hypocrasy/NPUSoC/doc/海报.png

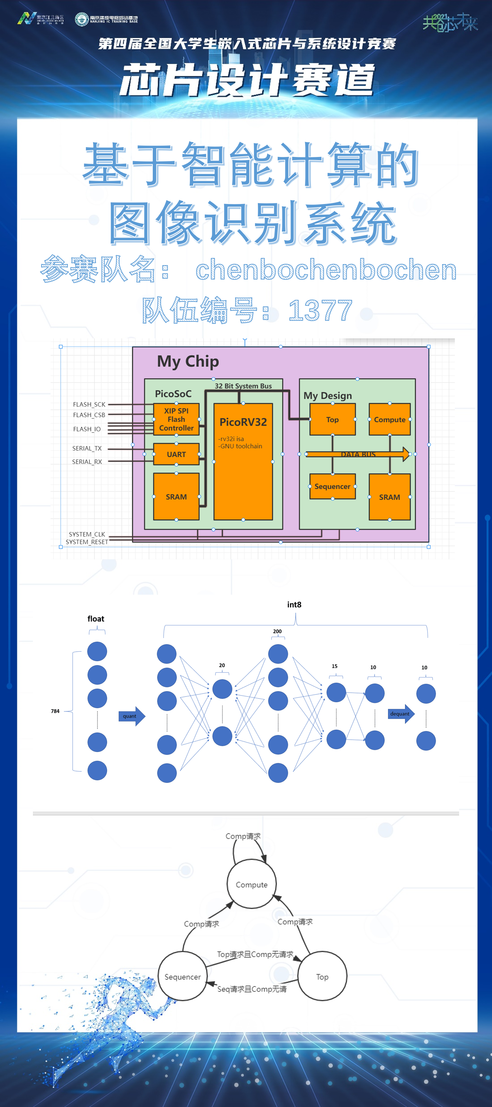
doc/海报.png
