hypocrasy/NPUSoC/spyglass/spyglass-1/consolidated_reports/Design_Read/README

################################################################################
#
# This file has been generated by SpyGlass:
#     Consolidated Reports Created by: team3_03
#     Consolidated Reports Created on: Thu Oct  7 14:20:48 2021
#     Working Directory              : /home/users/team3_03/Desktop/design2021/spyglass
#     Consolidated Reports Location  : ./spyglass-1/consolidated_reports/Design_Read/
#     SpyGlass Version               : SpyGlass_vQ-2020.03-SP2-6
#
################################################################################

This directory contains critical reports generated in current run
In case this directory needs to be compressed using gtar, you may use - 

    % gtar -cvzf <compressed_tar_file_name> ./spyglass-1/consolidated_reports/Design_Read/
