hypocrasy/NPUSoC/doc/芯片设计验证报告.pdf

## 第四届全国大学生嵌入式芯片与系统设计竞赛

## 芯片设计赛道

# 芯片设计验证报告

作品名称（必填）： 基于智能计算的图像识别系统

队伍编号（必填）： | 1377______________

参赛队名（必填）： chenbochenbochen_______

日期：2021 年 10 月 7 日

第四届全国大学生嵌入式芯片与系统设计竞赛芯片设计赛道

1

## 1. 测试点列表

简要说明测试点分解策略

测试点名称 | 覆盖范围 | 覆盖方式
功能类： Call LdAdd Excute MACC MACCZ MAX MMAXN MMAXZ MNIST ReLU Store | 典型值 | coverage
| 边界值 | coverage
| 异常值 | directtest
| Cross | coverage

接口类:
场景类（选填，有可以填）
性能类（选填，有可以填）
异常类（选填，有可以填）

## 2. 验证方案 主要验证组件

组件名 | 功能描述
Sequence | 发射指令并处理跳转指令
Compute | 对数据进行计算处理返回结果
Top | 接受外部的 io 指令

## 验证方案：框图+说明

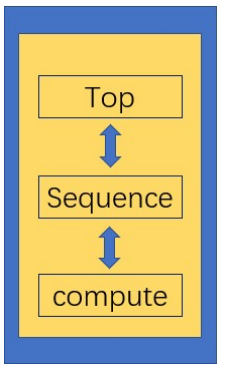
[picture p28: figure]
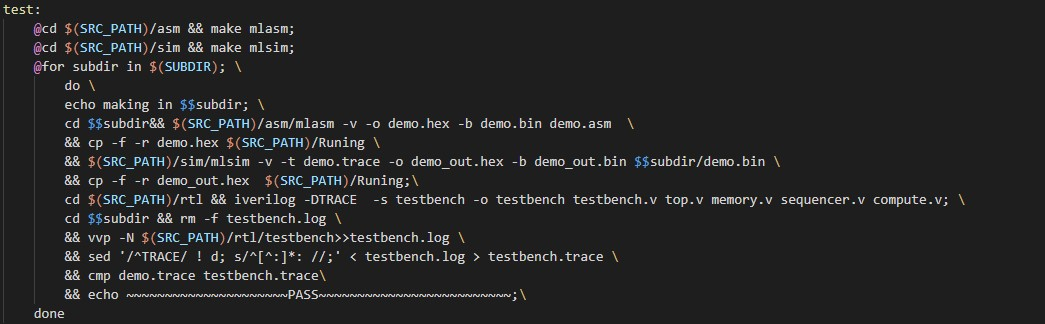
[picture p29: figure]

2

根据框图简要说明验证方案的流程
首 先 将 testcase 通 过 编 译 汇 编 指 令 为 hex 文 件 ， 通 过 对 top_moudule 施加 testbench 后，top 进行状态跳转让 sequence 发射指令至 compute 进行运算，运算成功后将结果写回存储，然 后对比行为模型的存储和过程的 trace 即可。

## 3. 功能覆盖率分析 覆盖率结果（截图）

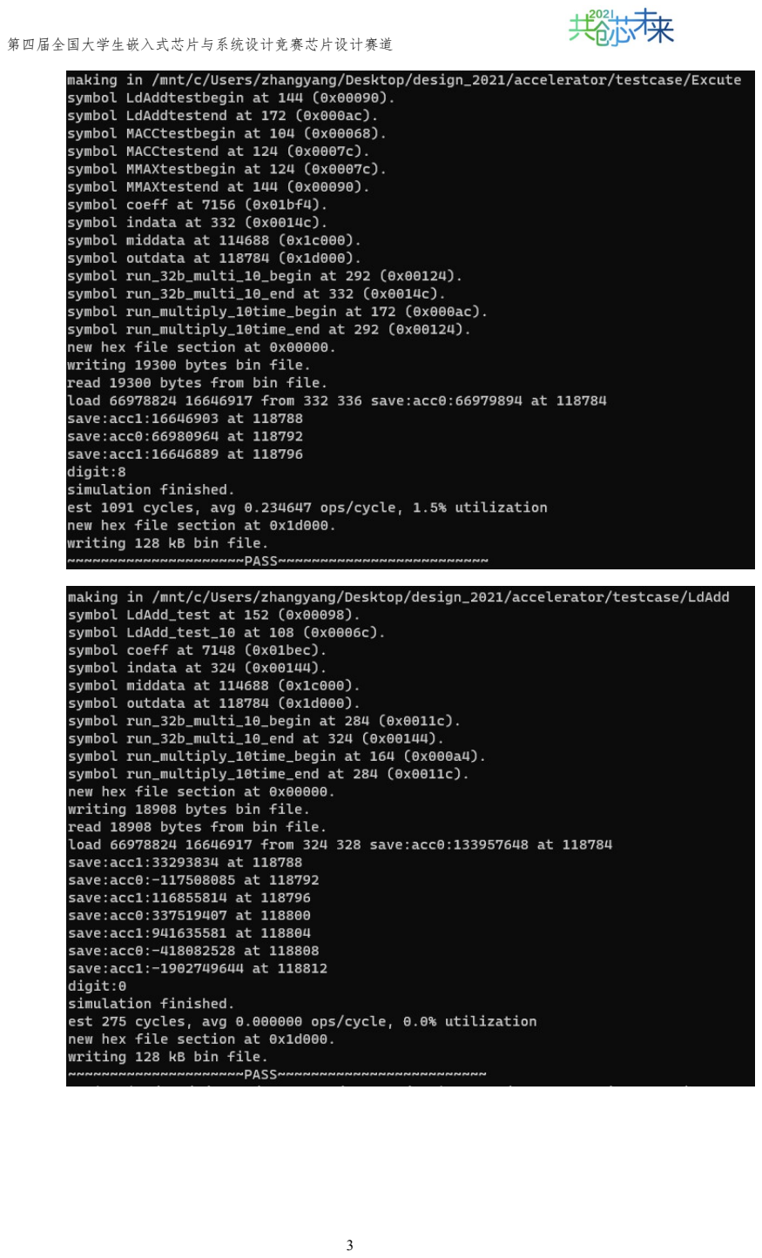
[picture p30: page 4]

3

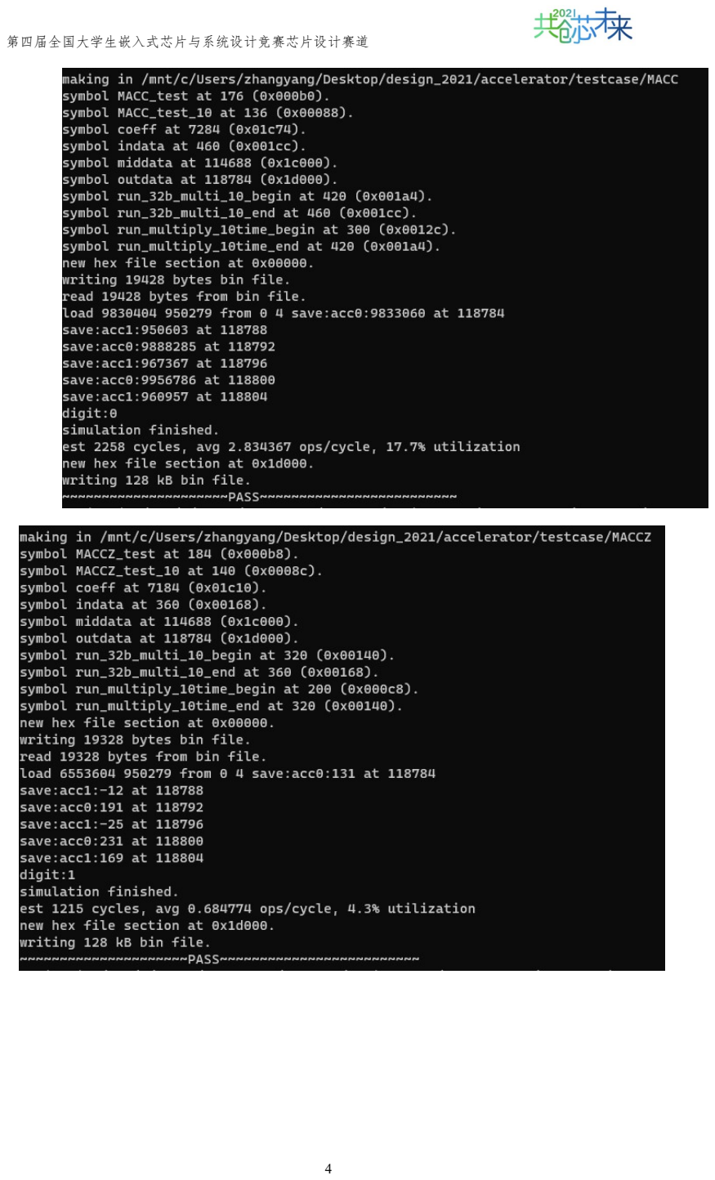
[picture p31: page 5]

4

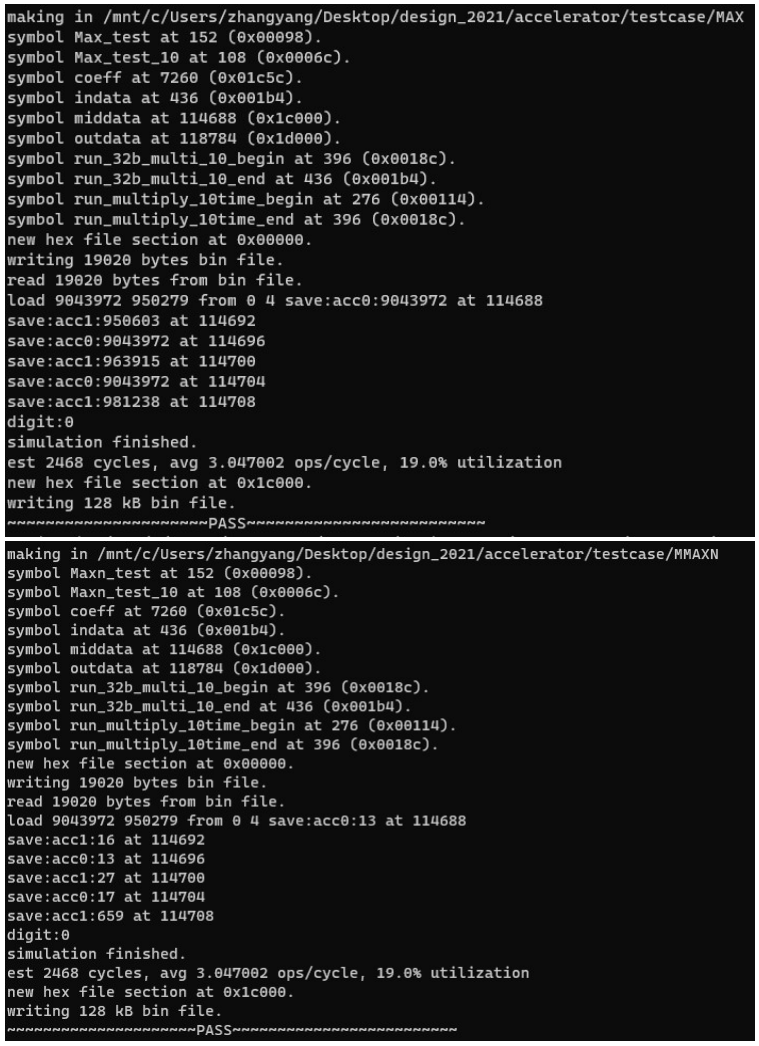
[picture p32: figure]

5

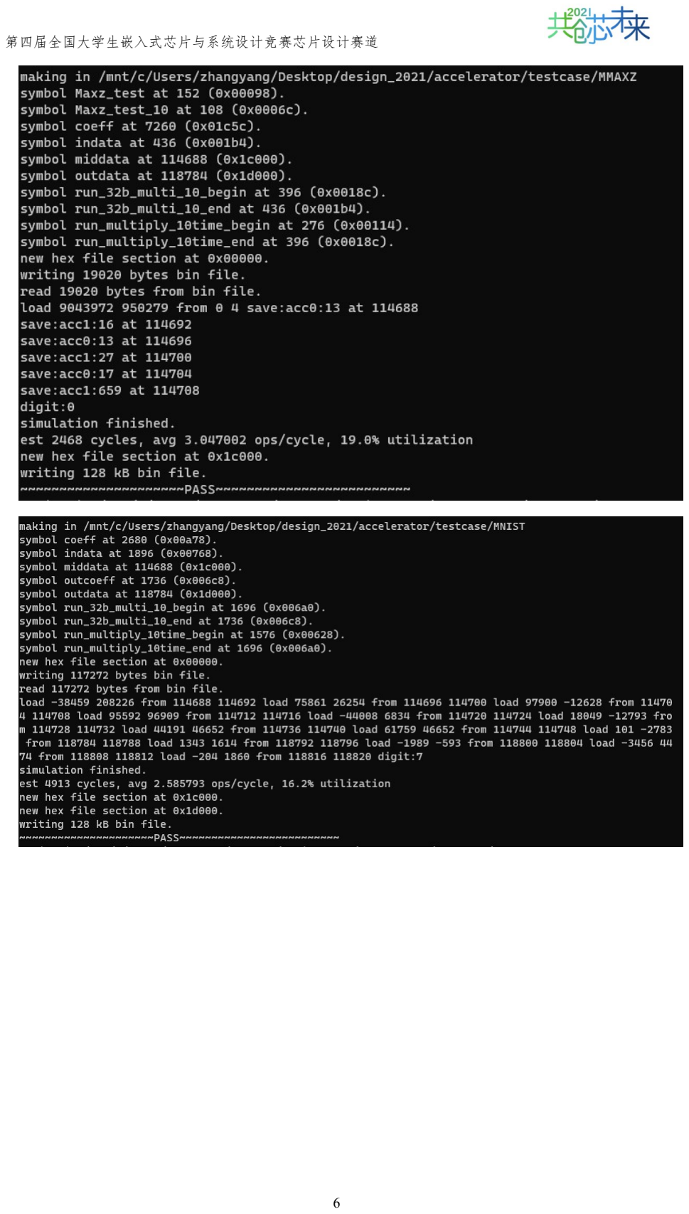
[picture p33: page 7]

6

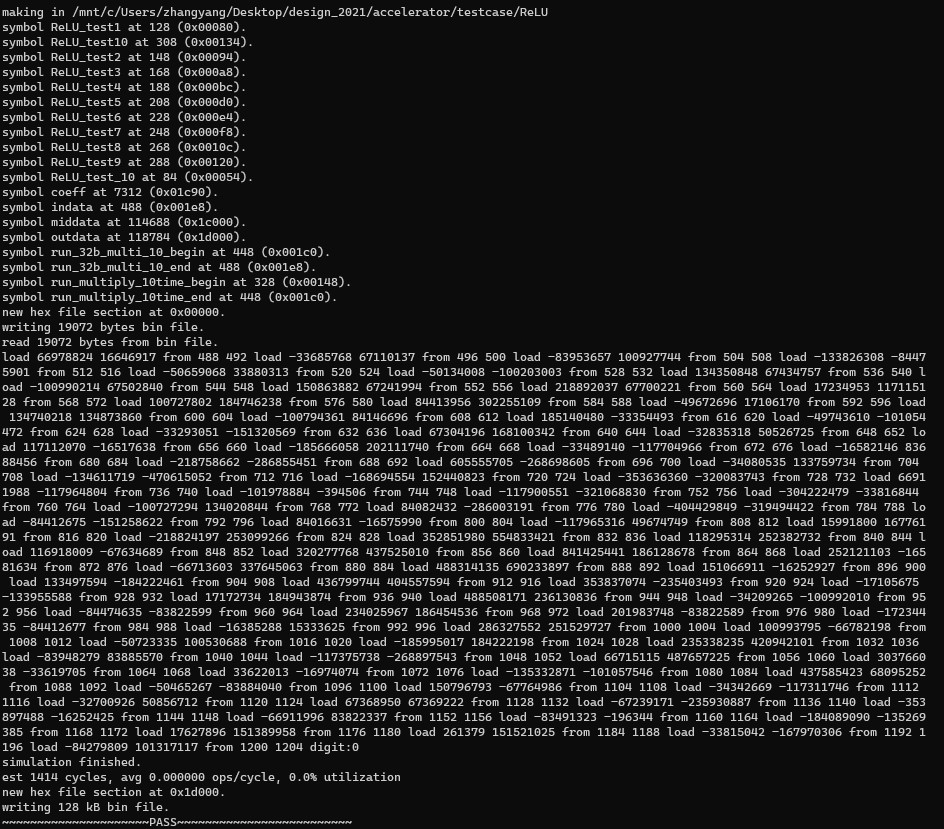
[picture p34: figure]

7

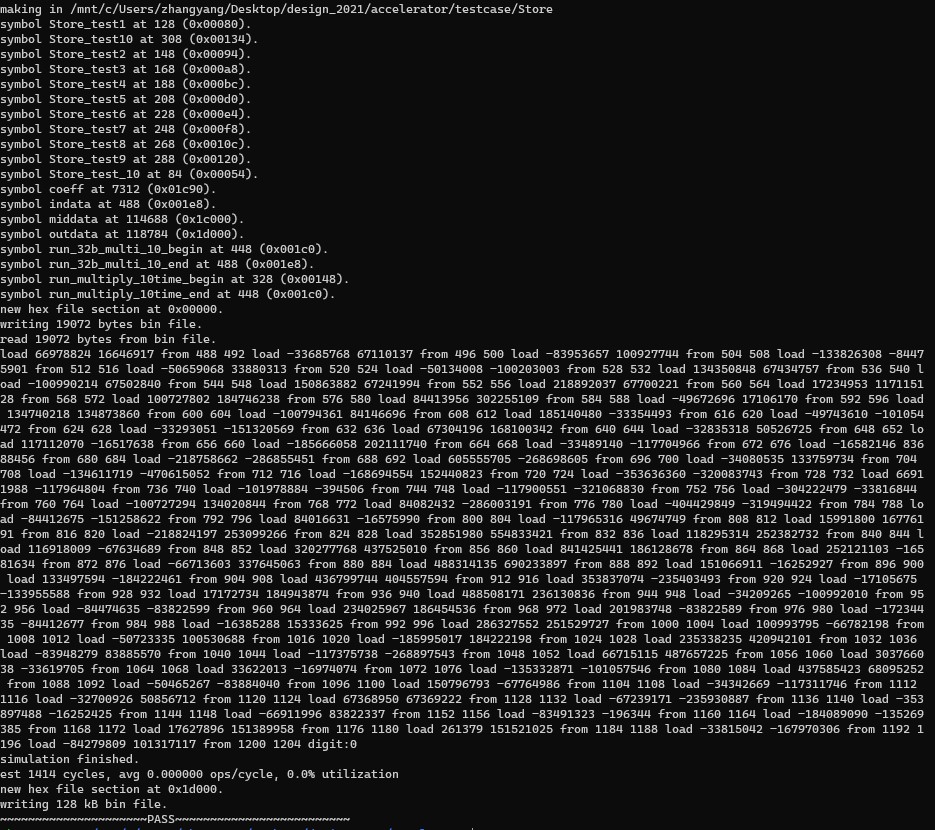
[picture p35: figure]

8

## 结果分析（重点分析没有覆盖的部分）

大部分指令在正常执行时都可以覆盖到，未覆盖的部分有以下情况： Excute 指令：在 LEN 为 0 时会导致计数器的溢出，执行会发生停 止
计算指令：在未初始化时累加器会出现未知态，必须使用初始化指 令首先进行计算，否则会出现未知态。
Load 指令后的四个周期内目标存储处于亚稳态，无法进行访问，否 则会出现未知结果。
Call 指令的最大深度只有 256，超过该深度时，返回后无法执行下 一条语句。

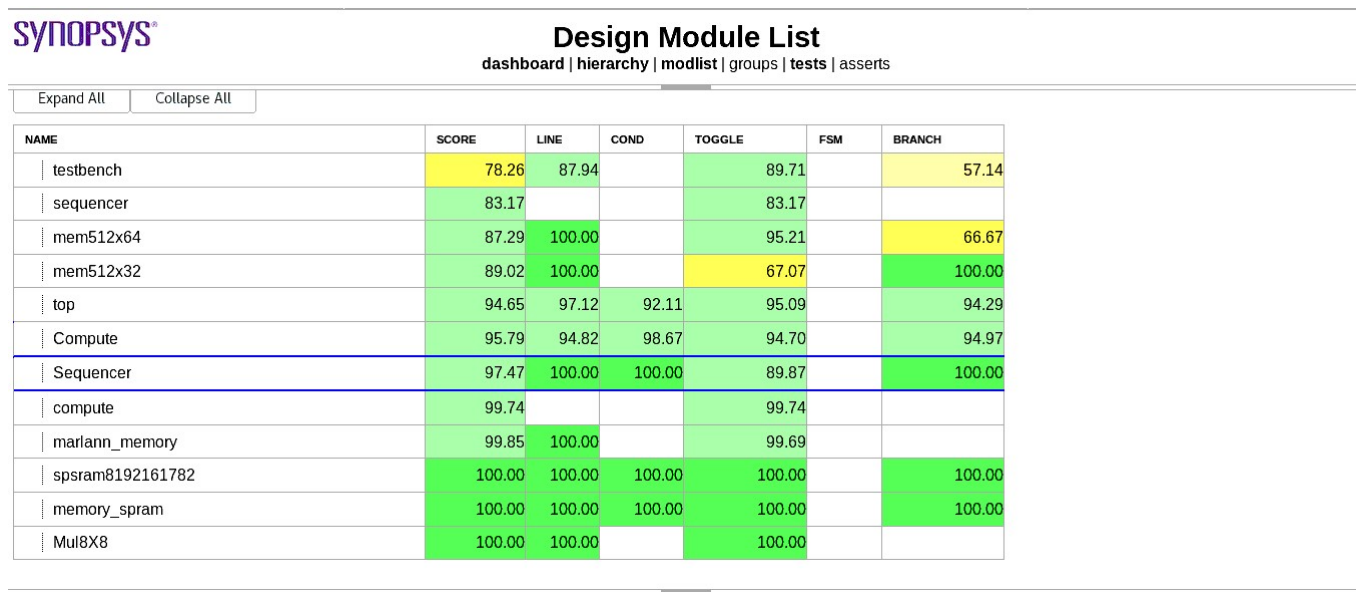
[picture p36: figure]

9

## 4. 代码覆盖率分析 覆盖率结果（截图）

## 结果分析（重点分析没有覆盖的部分）

尝试分析没有覆盖部分产生的原因，以及在未来有何策略上的 改进
Sequence：
Reset：缺少从 0=>1,因为软件指令不控制 Reset 信号 Addr：程序开始地址，因为 testbench 固定执行地址为 0，所 以 addr 的值总是为 0
Smem_addr[0]:每条指令是 32bit 即四字节，Smem_addr[0] 是地址的倒数第二位，所以总是为 0

## 5. 条件覆盖率分析 覆盖率结果（截图）

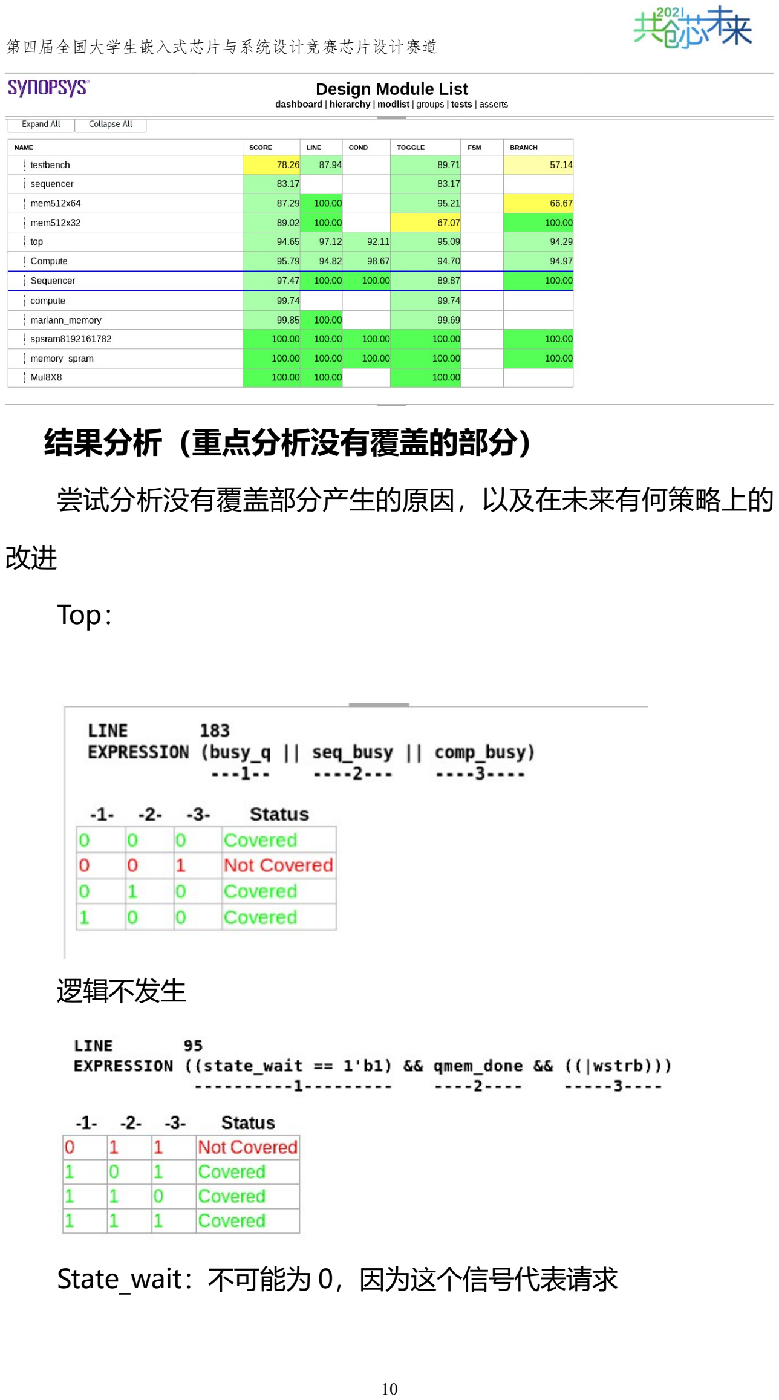
[picture p37: page 11]

10

## 结果分析（重点分析没有覆盖的部分）

尝试分析没有覆盖部分产生的原因，以及在未来有何策略上的 改进
Top：

逻辑不发生

State_wait：不可能为 0，因为这个信号代表请求

11

## 6. 用例激励随机性分析

我们采用 NIST 进行对数据的随机性检验，共包含以下 16 个方 面：
1) 频率检验（Frequency Test）
2) 块内频数检验（Frequency Test within a Block）
3) 游程检验（Runs Test）
4) 块内最长游程检验（Test for the Longest Run of Ones in a Block）
5) 二元矩阵秩检验（Binary Matrix Rank Test）
6) 离 散 傅 里 叶 变 换 检 验 （ Discrete Fourier Transform (Spectral) Test）
7) 非 重 叠 模 块 匹 配 检 验 （ Non-overlapping Template Matching Test）
8) 重叠模块匹配检验（Overlapping Template Matching Test）
9) Maurer 的通用统计检验（Maurer's“Universal Statistical” Test）
10) Lempel-Ziv 压缩检验 （Lempel-Ziv Compression Test）
11) 线性复杂度检验（Linear Complexity Test）
12) 序列检验（Serial Test）
13) 近似熵检验（Approximate Entropy Test）
14) 累加和检验（Cumulative Sums (Cusum) Test）
15) 随机游动检验（Random Excursions Test）

12

16) 随机游动状态频数检验（Random Excursions Variant Test）

检验报告如下：

------------------------------------------------------------------------------ C1 C2 C3 C4 C5 C6 C7 C8 C9C10 P-VALUE PROPORTION STATISTICALTEST

------------------------------------------------------------------------------ 1 4 5 1 6 3 0 6 0 4 0.054199 30/30 Frequency

3 2 4 5 2 0 5 4 5 0 0.253551 30/30 BlockFrequency

2 4 5 4 0 1 3 2 6 3 0.350485 30/30 CumulativeSums

0 2 9 1 4 1 8 0 3 2 0.000439 30/30 CumulativeSums

1 4 2 1 0 2 2 7 5 6 0.054199 30/30 Runs

5 1 1 5 4 4 3 1 2 4 0.534146 30/30 LongestRun

2 4 4 7 0 1 1 5 4 2 0.122325 30/30 Rank

16 4 2 2 4 1 0 0 1 0 0.000000 * 24/30 * FFT

3 3 1 6 4 1 3 3 2 4 0.671779 30/30 NonOverlappingTemplate

8 2 1 3 3 3 2 3 1 4 0.213309 29/30 NonOverlappingTemplate

1 1 2 7 1 5 3 5 3 2 0.178278 30/30 NonOverlappingTemplate

7 3 2 4 4 4 1 3 1 1 0.299251 27/30 * NonOverlappingTemplate

3 2 3 2 0 1 4 6 5 4 0.350485 30/30 NonOverlappingTemplate

4 3 2 5 3 2 3 3 3 2 0.976060 30/30 NonOverlappingTemplate

7 1 1 3 0 2 4 4 4 4 0.178278 28/30 NonOverlappingTemplate

7 3 3 3 3 1 1 4 2 3 0.468595 28/30 NonOverlappingTemplate

3 3 3 4 1 1 6 6 2 1 0.299251 29/30 NonOverlappingTemplate

13

5 2 4 3 1 4 3 3 2 3 0.911413 29/30 NonOverlappingTemplate

4 1 4 3 4 3 2 5 2 2 0.862344 30/30 NonOverlappingTemplate

7 5 1 3 3 2 3 1 2 3 0.350485 29/30 NonOverlappingTemplate

1 3 1 6 3 1 5 4 1 5 0.253551 30/30 NonOverlappingTemplate

8 0 0 6 3 1 7 0 2 3 0.001232 27/30 * NonOverlappingTemplate

3 2 1 2 4 1 6 8 2 1 0.054199 30/30 NonOverlappingTemplate

6 1 1 1 2 3 4 5 3 4 0.407091 29/30 NonOverlappingTemplate

5 1 6 4 4 2 3 0 3 2 0.350485 28/30 NonOverlappingTemplate

4 1 1 3 3 3 4 4 2 5 0.804337 30/30 NonOverlappingTemplate

5 2 2 2 5 3 3 4 1 3 0.804337 29/30 NonOverlappingTemplate

2 2 6 7 1 1 3 2 4 2 0.178278 30/30 NonOverlappingTemplate

1 2 1 3 6 1 3 4 3 6 0.299251 30/30 NonOverlappingTemplate

6 0 3 2 7 5 3 0 2 2 0.054199 29/30 NonOverlappingTemplate

4 5 3 4 4 4 2 2 2 0 0.671779 27/30 * NonOverlappingTemplate

0 1 1 1 3 3 6 6 0 9 0.000954 30/30 NonOverlappingTemplate

1 2 6 1 5 6 0 2 1 6 0.035174 30/30 NonOverlappingTemplate

7 5 1 2 2 4 0 3 2 4 0.178278 30/30 NonOverlappingTemplate

3 2 5 3 3 2 4 2 2 4 0.949602 30/30 NonOverlappingTemplate

4 5 3 0 2 1 2 7 4 2 0.178278 30/30 NonOverlappingTemplate

1 2 1 8 5 1 5 2 4 1 0.043745 30/30 NonOverlappingTemplate

4 4 7 3 1 2 5 1 2 1 0.213309 30/30 NonOverlappingTemplate

0 0 2 6 4 3 5 2 1 7 0.035174 30/30 NonOverlappingTemplate

14

3 3 2 4 3 2 2 4 3 4 0.991468 30/30 NonOverlappingTemplate

3 2 4 3 2 4 4 1 2 5 0.862344 29/30 NonOverlappingTemplate

4 2 1 2 1 8 2 7 2 1 0.022503 29/30 NonOverlappingTemplate

5 3 3 5 5 0 2 2 3 2 0.534146 30/30 NonOverlappingTemplate

0 3 2 1 5 4 3 4 3 5 0.534146 30/30 NonOverlappingTemplate

2 1 3 2 3 3 2 5 3 6 0.671779 30/30 NonOverlappingTemplate

3 3 7 3 5 4 0 0 3 2 0.148094 28/30 NonOverlappingTemplate

5 1 3 2 4 4 3 3 1 4 0.804337 27/30 * NonOverlappingTemplate

3 3 4 5 2 3 2 2 5 1 0.804337 30/30 NonOverlappingTemplate

5 3 3 0 4 2 1 3 1 8 0.066882 30/30 NonOverlappingTemplate

6 2 2 2 5 3 6 2 2 0 0.213309 30/30 NonOverlappingTemplate

1 1 2 4 4 6 3 6 1 2 0.253551 30/30 NonOverlappingTemplate

1 3 3 6 2 4 3 3 2 3 0.804337 30/30 NonOverlappingTemplate

3 1 2 4 1 7 3 3 2 4 0.407091 29/30 NonOverlappingTemplate

5 3 0 0 1 3 5 5 3 5 0.178278 28/30 NonOverlappingTemplate

2 4 1 4 5 5 2 3 3 1 0.671779 29/30 NonOverlappingTemplate

2 1 2 3 1 2 7 8 2 2 0.035174 30/30 NonOverlappingTemplate

5 2 4 4 3 2 4 2 0 4 0.671779 30/30 NonOverlappingTemplate

1 4 3 5 2 3 5 5 1 1 0.468595 30/30 NonOverlappingTemplate

3 2 7 3 3 3 3 3 2 1 0.602458 30/30 NonOverlappingTemplate

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

0 0 0 0 0 0 0 0 0 0 ---- ------ RandomExcursionsVariant

0 0 0 0 0 0 0 0 0 0 ---- ------ RandomExcursionsVariant

0 0 0 0 0 0 0 0 0 0 ---- ------ RandomExcursionsVariant

3 3 1 2 0 2 2 2 7 8 0.022503 30/30 Serial

4 2 0 2 5 1 2 5 5 4 0.350485 30/30 Serial

6 1 4 3 3 1 1 5 2 4 0.407091 3

0/30 LinearComplexity

## 7. 验证环境 warning QA

针对验证 log 中的 warning 进行分析，回答是否会影响结果， 可以尝试分析原因
Miss braces in $$fflush call :缺少括号，属于代码规范
