hypocrasy/NPUSoC/spyglass/spyglass-1/soctop/.SG_SaveRestoreDB/autogenerated__default_snapshot/analyzer/1633596132_macro_usage.txt

begin 0
    0 122 0 ""
    0 960 1 "    0 966 0 ""
end
begin 1
end
begin 2
    2 548 4 "empty_statement"
    2 551 4 "empty_statement"
    2 554 4 "empty_statement"
    2 557 4 "empty_statement"
    2 560 4 "empty_statement"
    2 595 4 "empty_statement"
    2 596 4 "empty_statement"
    2 597 4 "empty_statement"
    2 598 4 "empty_statement"
    2 621 4 "empty_statement"
    2 622 4 "empty_statement"
    2 629 4 "empty_statement"
    2 630 4 "empty_statement"
    2 689 3 ""
    2 690 3 ""
    2 691 3 ""
    2 692 3 ""
    2 693 3 ""
    2 694 3 ""
    2 695 3 ""
    2 696 3 ""
    2 697 3 ""
    2 1178 3 ""
    2 1495 2 ""
    2 1498 2 ""
    2 1552 2 ""
    2 1581 2 ""
    2 1587 2 ""
    2 1601 2 ""
    2 1612 2 ""
    2 1645 2 ""
    2 1653 2 ""
    2 1666 2 ""
    2 1675 2 ""
    2 1684 2 ""
    2 1691 2 ""
    2 1699 2 ""
    2 1707 2 ""
    2 1719 2 ""
    2 1724 2 ""
    2 1754 2 ""
    2 1773 2 ""
    2 1918 2 ""
    2 1925 2 ""
    2 1933 2 ""
end
begin 3
    3 21 5 "    3 28 6 ""
    3 208 6 "CHENBO_MEM"
end
begin 4
    4 282 1 "    4 288 0 ""
end
begin 5
end
begin 6
end
begin 7
end
begin 8
end
begin 9
end
begin 10
end
