hypocrasy/NPUSoC/spyglass/spyglass-1/soctop/cdc/cdc_setup_check/spyglass_spysch/tag_name_id_mapping.txt

0,SG_PARENT_CHILD_MSGTAG
1,SG_SIGNATURE
2,VCLINT_RCA_TAG
3,MSG_ATTR_HOLDER
4,MSG_GRP_TAG
5,MSG_GRP_TOOLTIP_TAG
6,SCH_STATIC_AUXI_AUTOLOAD_TAG_LIST
7,SCH_IS_AUTO_ABSTRACTION
8,SCH_HPDB_RULE_TAG
9,SCH_LOAD_PARTIAL_RULE_TAG
10,STATUS
11,TEMPLATE
12,RULE_ORDER
13,RULEGROUP
14,POLICY
15,INCR
16,BUILTIN
17,BBoxEng
18,BBoxEngAuxiInfo
19,LIBMAP
20,SDCMODE
21,DFT_MSG_GROUP
22,Open_RCA_Debug_Sheet
23,Open_SVA_Constraint_Sheet
24,Open_Relevant_Signal_Sheet
25,Open_Sp_Sheet
26,SG_TCL_COMMANDS
27,SG_MSG_GRP_HEADER_TEXT
28,Sp_Sheet_File_Name
29,Equiv_SDC_XYZ_Ref_Tag
30,Equiv_SDC_XYZ_Impl_Tag
31,SPG_BLOCKS
32,SPG_RULETAG_SCH_INFO_RULE
33,SPG_MSGTAG_HIERARCHY
34,DomainMatrix_SS
35,ClocksDomainMissing_TAG
36,ClocksDomainConflict_TAG
37,SDCMapping_TAG
38,SDC_Unparsed_Commands_TAG
39,SDC_Unsupported_Commands_TAG
40,DFT_HPDB_MSG_TAG
41,DFT_SCH_STATIC_AUXI_AUTOLOAD_MSG_TAG_LIST
42,SG_Msg_ReportNLine_Tag
43,SG_Rule_ReportNLine_Tag
44,SG_WF_RULE_DATA
45,SG_WF_MSG_DATA
46,CLK_SCH_MATRIX
47,CLK_SCH_CONE
48,CLK_SCH_MATRIX2
49,CLK_SCH_CONE2
50,ADVCDC_CONSTR_SS_SCH
51,ADVCDC_RELEVANT_SIG_SS_SCH
52,AC_INITSTATE01_SS_SCH
53,AC_INITSTATE01_SS_SCH01
54,AC_ABSTRACT_VALIDATION02_PORT
55,AC_ABSTRACT_VALIDATION02_MATCHATTR
56,ADV_CLK_CDC_ANALYSIS_SS
57,AC_CROSS_ANALYSIS_TAG_FOR_GUI
58,ADV_CLK_SYNC_SS_SCH
59,ADV_CLK_SYNC_SourceDomainID
60,AC_ABSTRACT_VALIDATION02_SS_SCH
61,ADV_CLK_SYNC_ENEXPR_SS_SCH
62,AC_REPEATER01_SS_SCH
63,module_based_reporting_tag
64,tag_parent_module_name
65,AC_CONV_SS_SCH
66,AC_CONV_SUB_SS_SCH
67,RESET_INFO_01_SS_SCH
68,AC_DATAHOLD_SS_SCH
69,ADV_XCLK_SS_SCH
70,AR_GLITCH02_SS_SCH
71,AC_GLITCH03_SS_SCH
72,DELTA_DELAY02_SS_SCH
73,CDC_ABSTRACT_VALIDATION_SS_SCH
74,CDC_ADV_CDC_SCH
75,CDC_ABSTRACT_CLK_MAPPING_SS_SCH
76,CLK_SYNC09_SS_SCH
77,QS_CSV_TAG
78,VIRT_CLK_MAP_SS_SCH
79,CLOCK_SYNC05_SS_SCH
80,CLOCK_SYNC05A_SS_SCH
81,CLOCK_SYNC06_SS_SCH
82,CLOCK_SYNC06A_SS_SCH
83,AC_CP01_CSV_TAG
84,AC_CP02_CSV_TAG
85,AC_RV01_CSV_TAG
86,RESET_INFO09D_SS_SCH
87,AC_ABSTRACT_VALIDATION02_COMBO_SS_SCH
88,AC_ABSTRACT_VALIDATION02_CLOCKS_DATA
89,AC_ABSTRACT_VALIDATION02_DATA_SS_SCH
90,AC_ABSTRACT_VALIDATION02_QUASI_SS_SCH
91,AC_ABSTRACT_VALIDATION02_CASE_SS_SCH
92,AC_ABSTRACT_VALIDATION02_CLOCK_SS_SCH
93,AC_ABSTRACT_VALIDATION02_RESET_SS_SCH
94,AC_ABSTRACT_VALIDATION02_QUASI_DESCLK_DATA
95,RESET_INFO09B_CLOCKS_DATA
96,RESET_INFO09B_SS_SCH
97,RESET_CHECK07_SS_SCH
98,RESET_CHECK12_SS_SCH
99,CLOCK_INFO03A_SS_SCH
100,SETUP_LIBRARY02_SS_SCH
101,AC_PSYNC_SS_SCH
102,AC_COHERENCY06_SS_SCH
103,AC_COHERENCY06A_SS_SCH
104,AC_CONV_DEPTH_SRC
105,SETUP_LIBRARY_SS_SCH
106,SETUP_LIBRARY_SS_RTL
107,SG_SE_COCKPIT
108,Ac_glitch03_enable_tag
109,Ac_cdc01_SFF_SS_SCH
110,Ac_cdc08_SFF_SS_SCH
111,AC_FIFO01_SFF_SS_SCH
112,Ac_conv02_SFF_SS_SCH
113,Ac_conv04_SFF_SS_SCH
114,AC_CONV04_SOURCE_NAME
115,AC_CONV04_SOURCE_CLOCK
116,AC_CONV04_SOURCE_CLOCK_TAG
117,AC_CONV04_SOURCE_CLOCK_TAG_ID
118,AC_CONV04_DESTINATION_CLOCK
119,AC_CONV04_DESTINATION_CLOCK_TAG
120,AC_CONV04_DESTINATION_CLOCK_TAG_ID
121,Ac_conv05_SFF_SS_SCH
122,AC_CONV_HIER_MODULE
123,AC_CONV_DATA_TAG
124,AC_GLITCH03_SFF_SS_SCH
125,AC_DATAHOLD01_SFF_SS_SCH
126,CDC_MULTI_MODE_INFO
127,ADV_CLK_SYNC_RTL2NETLISTSTAT
128,SETUP_PORT_SS_SCH
129,SETUP_PORT_SDC_TAG
130,RESET_COVERAGE_INFO_SS_RST_SCH
131,RESET_COVERAGE_INFO_SS_SCH
132,DERIVED_RESET_INFO_SS_SCH
133,DERIVED_CLOCK_INFO_SS_SCH
134,PORT_DERIVED_CLOCK_INFO_SS_SCH
135,PORT_DERIVED_RESET_INFO_SS_SCH
136,SETUP_BBOX01_SS_SCH
137,RESET_CHECK04_SS_SCH
138,SETUP_BBOX01_SDC_TAG
139,Open_Reactive_Witness
140,Open_Coverage_Witness
141,ClockMatrix01_SS
142,RDC_QUALIFIER_MSG_TAG
143,RDC_SRC_RESETS_MSG_TAG
144,RDC_DES_RESETS_MSG_TAG
145,RDC_PARENT_INSTANCE_MSG_TAG
146,RDC_RECONV_SRC_MSG_TAG
147,RDC_SRC_CLOCK_DOM_MSG_TAG
148,RDC_DES_CLOCK_DOM_MSG_TAG
149,RDC_IS_DIFF_CLK_DOMAIN_MSG_TAG
150,AC_CROSS_ANALYSIS_DES_DOMAIN
151,AC_CROSS_ANALYSIS_SRC_DOMAIN
152,AC_CROSS_ANALYSIS_DES_MOD
153,AC_CROSS_ANALYSIS_SRC_MOD
154,AC_CROSS_ANALYSIS_CROSS_TYPE
155,AC_CROSS_ANALYSIS_QUAL_TYPE
156,AC_CROSS_ANALYSIS_QUAL_NAME
157,AC_CROSS_ANALYSIS_QUAL_DEPTH
158,AC_CROSS_ANALYSIS_ENABLE_CANDIDATE
159,AC_CROSS_ANALYSIS_ENABLE_EXPR
160,AC_CROSS_ANALYSIS_SRC_PARENT
161,AC_CROSS_ANALYSIS_DES_PARENT
162,AC_CROSS_ANALYSIS_CROSS_PARENT
163,AC_CROSS_ANALYSIS_CROSS_MODULE
164,AC_CROSS_ANALYSIS_CROSS_MODE
165,AC_CROSS_ANALYSIS_THROUGH_HIER_PINS
166,AC_CROSS_ANALYSIS_DOMAIN_MODE
167,AC_CROSS_ANALYSIS_RECONV_QUAL
168,AC_CROSS_ANALYSIS_COMMENTS
169,AC_CROSS_ANALYSIS_MUX
170,AC_CROSS_ANALYSIS_HIERPATH
171,AC_CROSS_ANALYSIS_CELLNAME
172,AC_CROSS_ANALYSIS_PRAGMA
173,AC_CROSS_ANALYSIS_NUM_FLOPS
174,AC_CROSS_ANALYSIS_DEST_CLOCK_PERIOD
175,AC_THROUGH_POINTS_DATA_TAG
176,SETUP_LIBRARY02_VIOL_INFO
177,RESET_SYNC02_VIOL_INFO
178,RESET_CHECK07_VIOL_INFO
179,AC_DOMAIN_OVERRIDE_VIOL_INFO
180,AC_PORT_COMBO_VALIDATION01_VIOL_INFO
181,CLOCK_INFO_05_MUX_TYPE
182,CLOCK_INFO_05_MUX_CLK
183,CLOCK_INFO_05_MUX_DOM
184,AR_RESTCROSS01_SS_SCH
