hypocrasy/NPUSoC/spyglass/spyglass-1/soctop/cdc/cdc_setup_check/spyglass_spysch/analyzer/1633595745_macro_usage.txt

begin 0
    0 122 0 ""
    0 960 1 "    0 966 0 ""
end
begin 1
end
begin 2
    2 548 4 "empty_statement"
    2 551 4 "empty_statement"
    2 554 4 "empty_statement"
    2 557 4 "empty_statement"
    2 560 4 "empty_statement"
    2 595 4 "empty_statement"
    2 596 4 "empty_statement"
    2 597 4 "empty_statement"
    2 598 4 "empty_statement"
    2 621 4 "empty_statement"
    2 622 4 "empty_statement"
    2 629 4 "empty_statement"
    2 630 4 "empty_statement"
    2 689 3 ""
    2 690 3 ""
    2 691 3 ""
    2 692 3 ""
    2 693 3 ""
    2 694 3 ""
    2 695 3 ""
    2 696 3 ""
    2 697 3 ""
    2 1178 3 ""
    2 1495 2 ""
    2 1498 2 ""
    2 1552 2 ""
    2 1581 2 ""
    2 1587 2 ""
    2 1601 2 ""
    2 1612 2 ""
    2 1645 2 ""
    2 1653 2 ""
    2 1666 2 ""
    2 1675 2 ""
    2 1684 2 ""
    2 1691 2 ""
    2 1699 2 ""
    2 1707 2 ""
    2 1719 2 ""
    2 1724 2 ""
    2 1754 2 ""
    2 1773 2 ""
    2 1918 2 ""
    2 1925 2 ""
    2 1933 2 ""
end
begin 3
    3 21 5 "    3 28 6 ""
    3 208 6 "CHENBO_MEM"
end
begin 4
    4 282 1 "    4 288 0 ""
end
begin 5
end
begin 6
end
begin 7
end
begin 8
end
begin 9
    9 1466 9 "1.000"
    9 1466 9 "1.000"
    9 1466 10 "1.000"
    9 1466 9 "1.000"
    9 1466 10 "1.000"
    9 1466 9 "1.000"
    9 1468 9 "1.000"
    9 1468 9 "1.000"
    9 1468 10 "1.000"
    9 1468 9 "1.000"
    9 1468 10 "1.000"
    9 1468 9 "1.000"
    9 1470 9 "1.000"
    9 1470 9 "1.000"
    9 1470 10 "1.000"
    9 1470 9 "1.000"
    9 1470 10 "1.000"
    9 1470 9 "1.000"
    9 1472 9 "1.000"
    9 1472 9 "1.000"
    9 1472 10 "1.000"
    9 1472 9 "1.000"
    9 1472 10 "1.000"
    9 1472 9 "1.000"
    9 1474 9 "1.000"
    9 1474 9 "1.000"
    9 1474 10 "1.000"
    9 1474 9 "1.000"
    9 1474 10 "1.000"
    9 1474 9 "1.000"
    9 1476 9 "1.000"
    9 1476 9 "1.000"
    9 1476 10 "1.000"
    9 1476 9 "1.000"
    9 1476 10 "1.000"
    9 1476 9 "1.000"
    9 1478 9 "1.000"
    9 1478 9 "1.000"
    9 1478 10 "1.000"
    9 1478 9 "1.000"
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
end
begin 10
    10 1202 17 "1.000"
    10 1202 17 "1.000"
    10 1202 18 "1.000"
    10 1202 17 "1.000"
    10 1202 18 "1.000"
    10 1202 17 "1.000"
    10 1204 17 "1.000"
    10 1204 17 "1.000"
    10 1204 18 "1.000"
    10 1204 17 "1.000"
    10 1204 18 "1.000"
    10 1204 17 "1.000"
    10 1206 17 "1.000"
    10 1206 17 "1.000"
    10 1206 18 "1.000"
    10 1206 17 "1.000"
    10 1206 18 "1.000"
    10 1206 17 "1.000"
    10 1208 17 "1.000"
    10 1208 17 "1.000"
    10 1208 18 "1.000"
    10 1208 17 "1.000"
    10 1208 18 "1.000"
    10 1208 17 "1.000"
    10 1210 17 "1.000"
    10 1210 17 "1.000"
    10 1210 18 "1.000"
    10 1210 17 "1.000"
    10 1210 18 "1.000"
    10 1210 17 "1.000"
    10 1212 17 "1.000"
    10 1212 17 "1.000"
    10 1212 18 "1.000"
    10 1212 17 "1.000"
    10 1212 18 "1.000"
    10 1212 17 "1.000"
    10 1214 17 "1.000"
    10 1214 17 "1.000"
    10 1214 18 "1.000"
    10 1214 17 "1.000"
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
end
begin 11
end
begin 12
    12 5043 33 "1.000"
    12 5043 33 "1.000"
    12 5043 34 "1.000"
    12 5043 33 "1.000"
    12 5043 34 "1.000"
    12 5043 33 "1.000"
    12 5045 33 "1.000"
    12 5045 33 "1.000"
    12 5045 34 "1.000"
    12 5045 33 "1.000"
    12 5045 34 "1.000"
    12 5045 33 "1.000"
    12 5047 33 "1.000"
    12 5047 33 "1.000"
    12 5047 34 "1.000"
    12 5047 33 "1.000"
    12 5047 34 "1.000"
    12 5047 33 "1.000"
    12 5049 33 "1.000"
    12 5049 33 "1.000"
    12 5049 34 "1.000"
    12 5049 33 "1.000"
    12 5049 34 "1.000"
    12 5049 33 "1.000"
    12 5051 33 "1.000"
    12 5051 33 "1.000"
    12 5051 34 "1.000"
    12 5051 33 "1.000"
    12 5051 34 "1.000"
    12 5051 33 "1.000"
    12 5053 33 "1.000"
    12 5053 33 "1.000"
    12 5053 34 "1.000"
    12 5053 33 "1.000"
    12 5053 34 "1.000"
    12 5053 33 "1.000"
    12 5055 33 "1.000"
    12 5055 33 "1.000"
    12 5055 34 "1.000"
    12 5055 33 "1.000"
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
end
