hypocrasy/NPUSoC/doc/RTL_QA报告.pdf

第四届全国大学生嵌入式芯片与系统设计竞赛芯片设计赛道

# 第四届全国大学生嵌入式芯片与系统设计竞赛 芯片设计赛道

# RTL Q/A 报告

作品名称（必填）： | 基于智能计算的图像识别系统
队伍编号（必填）： | 1377
参赛队名（必填）： | chenbochenbochen

## 日期：2021 年 10 月 2 日

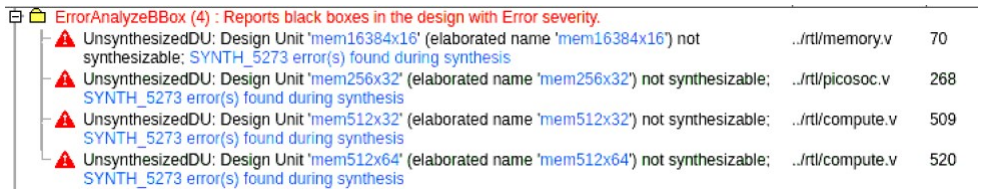
[picture p38: figure]
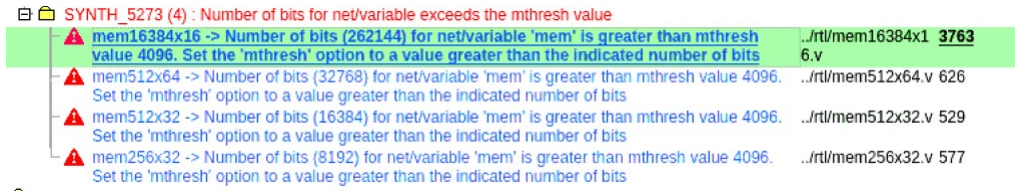
[picture p39: figure]

1

由于 lint 都没过，这里我们只进行了 spyglass 的 lint/adv_lint 检查。后

续工作还未完成。

这里的问题是 spyglass 没有正确的吃进去 sram 的 lib 文件，我们只好使用

v 文件，sram 的行为级模型不可综合产生的 Error。

同样是上面的问题。

这个是 PicoRV32 产生的 ERROR，我们选择保留原逻辑，不做改动。

其他问题均已解决，如下图。

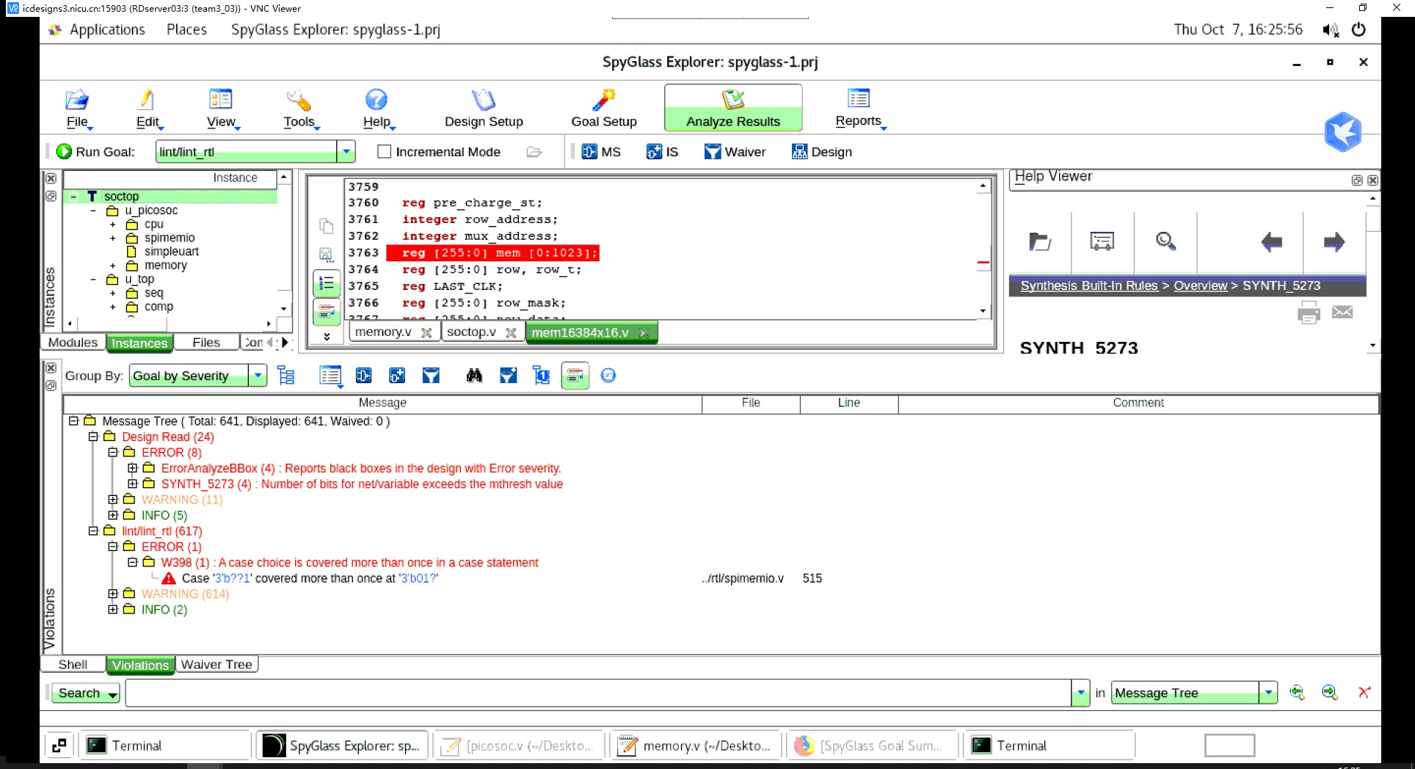
[picture p40: figure]

2
