hypocrasy/NPUSoC/rtl/mem16384x16.v

/* verilog_memcomp Version: 4.0.5-EAC1 */
/* common_memcomp Version: 4.0.5-beta22 */
/* lang compiler Version: 4.1.6-beta1 Jul 19 2012 13:55:19 */
//
//       CONFIDENTIAL AND PROPRIETARY SOFTWARE OF ARM PHYSICAL IP, INC.
//      
//       Copyright (c) 1993 - 2021 ARM Physical IP, Inc.  All Rights Reserved.
//      
//       Use of this Software is subject to the terms and conditions of the
//       applicable license agreement with ARM Physical IP, Inc.
//       In addition, this Software is protected by patents, copyright law 
//       and international treaties.
//      
//       The copyright notice(s) in this Software does not indicate actual or
//       intended publication of this Software.
//
//      Verilog model for Synchronous Single-Port Ram
//
//       Instance Name:              mem16384x16
//       Words:                      16384
//       Bits:                       16
//       Mux:                        16
//       Drive:                      6
//       Write Mask:                 On
//       Write Thru:                 Off
//       Extra Margin Adjustment:    On
//       Redundant Columns:          2
//       Test Muxes                  On
//       Power Gating:               Off
//       Retention:                  On
//       Pipeline:                   Off
//       Read Disturb Test:	        Off
//       
//       Creation Date:  Tue Oct  5 19:10:13 2021
//       Version: 	r1p2
//
//      Modeling Assumptions: This model supports full gate level simulation
//          including proper x-handling and timing check behavior.  Unit
//          delay timing is included in the model. Back-annotation of SDF
//          (v3.0 or v2.1) is supported.  SDF can be created utilyzing the delay
//          calculation views provided with this generator and supported
//          delay calculators.  All buses are modeled [MSB:LSB].  All 
//          ports are padded with Verilog primitives.
//
//      Modeling Limitations: None.
//
//      Known Bugs: None.
//
//      Known Work Arounds: N/A
//
`timescale 1 ns/1 ps
`define ARM_MEM_PROP 1.000
`define ARM_MEM_RETAIN 1.000
`define ARM_MEM_PERIOD 3.000
`define ARM_MEM_WIDTH 1.000
`define ARM_MEM_SETUP 1.000
`define ARM_MEM_HOLD 0.500
`define ARM_MEM_COLLISION 3.000
// If ARM_HVM_MODEL is defined at Simulator Command Line, it Selects the Hierarchical Verilog Model
`ifdef ARM_HVM_MODEL


module datapath_latch_mem16384x16 (CLK,Q_update,D_update,SE,SI,D,DFTRAMBYP,mem_path,XQ,Q);
	input CLK,Q_update,D_update,SE,SI,D,DFTRAMBYP,mem_path,XQ;
	output Q;

	reg    D_int;
	reg    Q;

   //  Model PHI2 portion
   always @(CLK or SE or SI or D) begin
      if (CLK === 1'b0) begin
         if (SE===1'b1)
           D_int=SI;
         else if (SE===1'bx)
           D_int=1'bx;
         else
           D_int=D;
      end
   end

   // model output side of RAM latch
   always @(posedge Q_update or posedge D_update or mem_path or posedge XQ) begin
      if (XQ===1'b0) begin
         if (DFTRAMBYP===1'b1)
           Q=D_int;
         else
           Q=mem_path;
      end
      else
        Q=1'bx;
   end
endmodule // datapath_latch_mem16384x16

// If ARM_UD_MODEL is defined at Simulator Command Line, it Selects the Fast Functional Model
`ifdef ARM_UD_MODEL

// Following parameter Values can be overridden at Simulator Command Line.

// ARM_UD_DP Defines the delay through Data Paths, for Memory Models it represents BIST MUX output delays.
`ifdef ARM_UD_DP
`else
`define ARM_UD_DP #0.001
`endif
// ARM_UD_CP Defines the delay through Clock Path Cells, for Memory Models it is not used.
`ifdef ARM_UD_CP
`else
`define ARM_UD_CP
`endif
// ARM_UD_SEQ Defines the delay through the Memory, for Memory Models it is used for CLK->Q delays.
`ifdef ARM_UD_SEQ
`else
`define ARM_UD_SEQ #0.01
`endif

`celldefine
// If POWER_PINS is defined at Simulator Command Line, it selects the module definition with Power Ports
`ifdef POWER_PINS
module mem16384x16 (VDDCE, VDDPE, VSSE, CENY, WENY, AY, GWENY, Q, SO, CLK, CEN, WEN,
    A, D, EMA, EMAW, TEN, TCEN, TWEN, TA, TD, GWEN, TGWEN, RET1N, SI, SE, DFTRAMBYP);
`else
module mem16384x16 (CENY, WENY, AY, GWENY, Q, SO, CLK, CEN, WEN, A, D, EMA, EMAW, TEN,
    TCEN, TWEN, TA, TD, GWEN, TGWEN, RET1N, SI, SE, DFTRAMBYP);
`endif

  parameter ASSERT_PREFIX = "";
  parameter BITS = 16;
  parameter WORDS = 16384;
  parameter MUX = 16;
  parameter MEM_WIDTH = 256; // redun block size 8, 128 on left, 128 on right
  parameter MEM_HEIGHT = 1024;
  parameter WP_SIZE = 1 ;
  parameter UPM_WIDTH = 3;
  parameter UPMW_WIDTH = 2;
  parameter UPMS_WIDTH = 0;

  output  CENY;
  output [15:0] WENY;
  output [13:0] AY;
  output  GWENY;
  output [15:0] Q;
  output [1:0] SO;
  input  CLK;
  input  CEN;
  input [15:0] WEN;
  input [13:0] A;
  input [15:0] D;
  input [2:0] EMA;
  input [1:0] EMAW;
  input  TEN;
  input  TCEN;
  input [15:0] TWEN;
  input [13:0] TA;
  input [15:0] TD;
  input  GWEN;
  input  TGWEN;
  input  RET1N;
  input [1:0] SI;
  input  SE;
  input  DFTRAMBYP;
`ifdef POWER_PINS
  inout VDDCE;
  inout VDDPE;
  inout VSSE;
`endif

  reg pre_charge_st;
  integer row_address;
  integer mux_address;
  reg [255:0] mem [0:1023];
  reg [255:0] row, row_t;
  reg LAST_CLK;
  reg [255:0] row_mask;
  reg [255:0] new_data;
  reg [255:0] data_out;
  reg [31:0] readLatch0;
  reg [31:0] shifted_readLatch0;
  reg  read_mux_sel0;
  reg  read_mux_sel0_p2;
  wire [15:0] Q_int;
  reg XQ, Q_update;
  reg XD_sh, D_sh_update;
  wire [15:0] D_int_bmux;
  reg [15:0] mem_path;
  reg [15:0] writeEnable;
  reg clk0_int;

  wire  CENY_;
  wire [15:0] WENY_;
  wire [13:0] AY_;
  wire  GWENY_;
  wire [15:0] Q_;
  wire [1:0] SO_;
 wire  CLK_;
  wire  CEN_;
  reg  CEN_int;
  reg  CEN_p2;
  wire [15:0] WEN_;
  reg [15:0] WEN_int;
  wire [13:0] A_;
  reg [13:0] A_int;
  wire [15:0] D_;
  reg [15:0] D_int;
  wire [2:0] EMA_;
  reg [2:0] EMA_int;
  wire [1:0] EMAW_;
  reg [1:0] EMAW_int;
  wire  TEN_;
  reg  TEN_int;
  wire  TCEN_;
  reg  TCEN_int;
  reg  TCEN_p2;
  wire [15:0] TWEN_;
  reg [15:0] TWEN_int;
  wire [13:0] TA_;
  reg [13:0] TA_int;
  wire [15:0] TD_;
  reg [15:0] TD_int;
  wire  GWEN_;
  reg  GWEN_int;
  wire  TGWEN_;
  reg  TGWEN_int;
  wire  RET1N_;
  reg  RET1N_int;
  wire [1:0] SI_;
  wire [1:0] SI_int;
  wire  SE_;
  reg  SE_int;
  wire  DFTRAMBYP_;
  reg  DFTRAMBYP_int;
  reg  DFTRAMBYP_p2;

  assign CENY = CENY_; 
  assign WENY[0] = WENY_[0]; 
  assign WENY[1] = WENY_[1]; 
  assign WENY[2] = WENY_[2]; 
  assign WENY[3] = WENY_[3]; 
  assign WENY[4] = WENY_[4]; 
  assign WENY[5] = WENY_[5]; 
  assign WENY[6] = WENY_[6]; 
  assign WENY[7] = WENY_[7]; 
  assign WENY[8] = WENY_[8]; 
  assign WENY[9] = WENY_[9]; 
  assign WENY[10] = WENY_[10]; 
  assign WENY[11] = WENY_[11]; 
  assign WENY[12] = WENY_[12]; 
  assign WENY[13] = WENY_[13]; 
  assign WENY[14] = WENY_[14]; 
  assign WENY[15] = WENY_[15]; 
  assign AY[0] = AY_[0]; 
  assign AY[1] = AY_[1]; 
  assign AY[2] = AY_[2]; 
  assign AY[3] = AY_[3]; 
  assign AY[4] = AY_[4]; 
  assign AY[5] = AY_[5]; 
  assign AY[6] = AY_[6]; 
  assign AY[7] = AY_[7]; 
  assign AY[8] = AY_[8]; 
  assign AY[9] = AY_[9]; 
  assign AY[10] = AY_[10]; 
  assign AY[11] = AY_[11]; 
  assign AY[12] = AY_[12]; 
  assign AY[13] = AY_[13]; 
  assign GWENY = GWENY_; 
  assign Q[0] = Q_[0]; 
  assign Q[1] = Q_[1]; 
  assign Q[2] = Q_[2]; 
  assign Q[3] = Q_[3]; 
  assign Q[4] = Q_[4]; 
  assign Q[5] = Q_[5]; 
  assign Q[6] = Q_[6]; 
  assign Q[7] = Q_[7]; 
  assign Q[8] = Q_[8]; 
  assign Q[9] = Q_[9]; 
  assign Q[10] = Q_[10]; 
  assign Q[11] = Q_[11]; 
  assign Q[12] = Q_[12]; 
  assign Q[13] = Q_[13]; 
  assign Q[14] = Q_[14]; 
  assign Q[15] = Q_[15]; 
  assign SO[0] = SO_[0]; 
  assign SO[1] = SO_[1]; 
  assign CLK_ = CLK;
  assign CEN_ = CEN;
  assign WEN_[0] = WEN[0];
  assign WEN_[1] = WEN[1];
  assign WEN_[2] = WEN[2];
  assign WEN_[3] = WEN[3];
  assign WEN_[4] = WEN[4];
  assign WEN_[5] = WEN[5];
  assign WEN_[6] = WEN[6];
  assign WEN_[7] = WEN[7];
  assign WEN_[8] = WEN[8];
  assign WEN_[9] = WEN[9];
  assign WEN_[10] = WEN[10];
  assign WEN_[11] = WEN[11];
  assign WEN_[12] = WEN[12];
  assign WEN_[13] = WEN[13];
  assign WEN_[14] = WEN[14];
  assign WEN_[15] = WEN[15];
  assign A_[0] = A[0];
  assign A_[1] = A[1];
  assign A_[2] = A[2];
  assign A_[3] = A[3];
  assign A_[4] = A[4];
  assign A_[5] = A[5];
  assign A_[6] = A[6];
  assign A_[7] = A[7];
  assign A_[8] = A[8];
  assign A_[9] = A[9];
  assign A_[10] = A[10];
  assign A_[11] = A[11];
  assign A_[12] = A[12];
  assign A_[13] = A[13];
  assign D_[0] = D[0];
  assign D_[1] = D[1];
  assign D_[2] = D[2];
  assign D_[3] = D[3];
  assign D_[4] = D[4];
  assign D_[5] = D[5];
  assign D_[6] = D[6];
  assign D_[7] = D[7];
  assign D_[8] = D[8];
  assign D_[9] = D[9];
  assign D_[10] = D[10];
  assign D_[11] = D[11];
  assign D_[12] = D[12];
  assign D_[13] = D[13];
  assign D_[14] = D[14];
  assign D_[15] = D[15];
  assign EMA_[0] = EMA[0];
  assign EMA_[1] = EMA[1];
  assign EMA_[2] = EMA[2];
  assign EMAW_[0] = EMAW[0];
  assign EMAW_[1] = EMAW[1];
  assign TEN_ = TEN;
  assign TCEN_ = TCEN;
  assign TWEN_[0] = TWEN[0];
  assign TWEN_[1] = TWEN[1];
  assign TWEN_[2] = TWEN[2];
  assign TWEN_[3] = TWEN[3];
  assign TWEN_[4] = TWEN[4];
  assign TWEN_[5] = TWEN[5];
  assign TWEN_[6] = TWEN[6];
  assign TWEN_[7] = TWEN[7];
  assign TWEN_[8] = TWEN[8];
  assign TWEN_[9] = TWEN[9];
  assign TWEN_[10] = TWEN[10];
  assign TWEN_[11] = TWEN[11];
  assign TWEN_[12] = TWEN[12];
  assign TWEN_[13] = TWEN[13];
  assign TWEN_[14] = TWEN[14];
  assign TWEN_[15] = TWEN[15];
  assign TA_[0] = TA[0];
  assign TA_[1] = TA[1];
  assign TA_[2] = TA[2];
  assign TA_[3] = TA[3];
  assign TA_[4] = TA[4];
  assign TA_[5] = TA[5];
  assign TA_[6] = TA[6];
  assign TA_[7] = TA[7];
  assign TA_[8] = TA[8];
  assign TA_[9] = TA[9];
  assign TA_[10] = TA[10];
  assign TA_[11] = TA[11];
  assign TA_[12] = TA[12];
  assign TA_[13] = TA[13];
  assign TD_[0] = TD[0];
  assign TD_[1] = TD[1];
  assign TD_[2] = TD[2];
  assign TD_[3] = TD[3];
  assign TD_[4] = TD[4];
  assign TD_[5] = TD[5];
  assign TD_[6] = TD[6];
  assign TD_[7] = TD[7];
  assign TD_[8] = TD[8];
  assign TD_[9] = TD[9];
  assign TD_[10] = TD[10];
  assign TD_[11] = TD[11];
  assign TD_[12] = TD[12];
  assign TD_[13] = TD[13];
  assign TD_[14] = TD[14];
  assign TD_[15] = TD[15];
  assign GWEN_ = GWEN;
  assign TGWEN_ = TGWEN;
  assign RET1N_ = RET1N;
  assign SI_[0] = SI[0];
  assign SI_[1] = SI[1];
  assign SE_ = SE;
  assign DFTRAMBYP_ = DFTRAMBYP;

  assign `ARM_UD_DP CENY_ = (RET1N_ | pre_charge_st) ? (DFTRAMBYP_ & (TEN_ ? CEN_ : TCEN_)) : 1'bx;
  assign `ARM_UD_DP WENY_ = (RET1N_ | pre_charge_st) ? ({16{DFTRAMBYP_}} & (TEN_ ? WEN_ : TWEN_)) : {16{1'bx}};
  assign `ARM_UD_DP AY_ = (RET1N_ | pre_charge_st) ? ({14{DFTRAMBYP_}} & (TEN_ ? A_ : TA_)) : {14{1'bx}};
  assign `ARM_UD_DP GWENY_ = (RET1N_ | pre_charge_st) ? (DFTRAMBYP_ & (TEN_ ? GWEN_ : TGWEN_)) : 1'bx;
  assign `ARM_UD_SEQ Q_ = (RET1N_ | pre_charge_st) ? ((Q_int)) : {16{1'bx}};
  assign `ARM_UD_DP SO_ = (RET1N_ | pre_charge_st) ? ({Q_[8], Q_[7]}) : {2{1'bx}};

// If INITIALIZE_MEMORY is defined at Simulator Command Line, it Initializes the Memory with all ZEROS.
`ifdef INITIALIZE_MEMORY
  integer i;
  initial begin
    #0;
    for (i = 0; i < MEM_HEIGHT; i = i + 1)
      mem[i] = {MEM_WIDTH{1'b0}};
  end
`endif
  always @ (EMA_) begin
  	if(EMA_ < 2) 
   	$display("Warning: Set Value for EMA doesn't match Default value 2 in %m at %0t", $time);
  end
  always @ (EMAW_) begin
  	if(EMAW_ < 0) 
   	$display("Warning: Set Value for EMAW doesn't match Default value 0 in %m at %0t", $time);
  end

  task failedWrite;
  input port_f;
  integer i;
  begin
    for (i = 0; i < MEM_HEIGHT; i = i + 1)
      mem[i] = {MEM_WIDTH{1'bx}};
  end
  endtask

  function isBitX;
    input bitval;
    begin
      isBitX = ( bitval===1'bx || bitval==1'bz ) ? 1'b1 : 1'b0;
    end
  endfunction

  function isBit1;
    input bitval;
    begin
      isBit1 = ( bitval===1'b1 ) ? 1'b1 : 1'b0;
    end
  endfunction



  task readWrite;
  begin
    if (GWEN_int !== 1'b1 && DFTRAMBYP_int=== 1'b0 && SE_int === 1'bx) begin
      failedWrite(0);
    end else if (DFTRAMBYP_int=== 1'b0 && SE_int === 1'b1) begin
      failedWrite(0);
        XQ = 1'b1; Q_update = 1'b1;
    end else if (RET1N_int === 1'bx || RET1N_int === 1'bz) begin
      failedWrite(0);
        XQ = 1'b1; Q_update = 1'b1;
    end else if (RET1N_int === 1'b0 && (CEN_int === 1'b0 || DFTRAMBYP_int === 1'b1)) begin
      failedWrite(0);
        XQ = 1'b1; Q_update = 1'b1;
    end else if (RET1N_int === 1'b0) begin
      // no cycle in retention mode
    end else if (^{(EMA_int & isBit1(DFTRAMBYP_int)), (EMAW_int & isBit1(DFTRAMBYP_int))} === 1'bx) begin
        XQ = 1'b1; Q_update = 1'b1;
    end else if (^{(CEN_int & !isBit1(DFTRAMBYP_int)), EMA_int, EMAW_int, RET1N_int} === 1'bx) begin
      failedWrite(0);
        XQ = 1'b1; Q_update = 1'b1;
    end else if ((A_int >= WORDS) && (CEN_int === 1'b0) && DFTRAMBYP_int === 1'b0) begin
        XQ = GWEN_int !== 1'b1 ? 1'b0 : 1'b1; Q_update = GWEN_int !== 1'b1 ? 1'b0 : 1'b1;
    end else if (CEN_int === 1'b0 && (^A_int) === 1'bx && DFTRAMBYP_int === 1'b0) begin
      failedWrite(0);
        XQ = 1'b1; Q_update = 1'b1;
    end else if (CEN_int === 1'b0 || DFTRAMBYP_int === 1'b1) begin
      if(isBitX(DFTRAMBYP_int) || isBitX(SE_int))
        D_int = {16{1'bx}};

      mux_address = (A_int & 4'b1111);
      row_address = (A_int >> 4);
      if (DFTRAMBYP_int !== 1'b1) begin
      if (row_address > 1023)
        row = {256{1'bx}};
      else
        row = mem[row_address];
      end
      if( (isBitX(GWEN_int) && DFTRAMBYP_int!==1) || isBitX(DFTRAMBYP_int) ) begin
        writeEnable = {16{1'bx}};
        D_int = {16{1'bx}};
      end else
          writeEnable = ~ ( {16{GWEN_int}} | {WEN_int[15], WEN_int[14], WEN_int[13],
          WEN_int[12], WEN_int[11], WEN_int[10], WEN_int[9], WEN_int[8], WEN_int[7],
          WEN_int[6], WEN_int[5], WEN_int[4], WEN_int[3], WEN_int[2], WEN_int[1], WEN_int[0]});
      if (GWEN_int !== 1'b1 || DFTRAMBYP_int === 1'b1 || DFTRAMBYP_int === 1'bx) begin
        row_mask =  ( {15'b000000000000000, writeEnable[15], 15'b000000000000000, writeEnable[14],
          15'b000000000000000, writeEnable[13], 15'b000000000000000, writeEnable[12],
          15'b000000000000000, writeEnable[11], 15'b000000000000000, writeEnable[10],
          15'b000000000000000, writeEnable[9], 15'b000000000000000, writeEnable[8],
          15'b000000000000000, writeEnable[7], 15'b000000000000000, writeEnable[6],
          15'b000000000000000, writeEnable[5], 15'b000000000000000, writeEnable[4],
          15'b000000000000000, writeEnable[3], 15'b000000000000000, writeEnable[2],
          15'b000000000000000, writeEnable[1], 15'b000000000000000, writeEnable[0]} << mux_address);
        new_data =  ( {15'b000000000000000, D_int[15], 15'b000000000000000, D_int[14],
          15'b000000000000000, D_int[13], 15'b000000000000000, D_int[12], 15'b000000000000000, D_int[11],
          15'b000000000000000, D_int[10], 15'b000000000000000, D_int[9], 15'b000000000000000, D_int[8],
          15'b000000000000000, D_int[7], 15'b000000000000000, D_int[6], 15'b000000000000000, D_int[5],
          15'b000000000000000, D_int[4], 15'b000000000000000, D_int[3], 15'b000000000000000, D_int[2],
          15'b000000000000000, D_int[1], 15'b000000000000000, D_int[0]} << mux_address);
        row = (row & ~row_mask) | (row_mask & (~row_mask | new_data));
        if (DFTRAMBYP_int === 1'b1 && SE_int === 1'b0) begin
        end else if (GWEN_int !== 1'b1 && DFTRAMBYP_int === 1'b1 && SE_int === 1'bx) begin
        	XQ = 1'b1; Q_update = 1'b1;
        end else begin
        mem[row_address] = row;
        end
      end else begin
        data_out = (row >> (mux_address%8));
        readLatch0 = {data_out[248], data_out[240], data_out[232], data_out[224], data_out[216],
          data_out[208], data_out[200], data_out[192], data_out[184], data_out[176],
          data_out[168], data_out[160], data_out[152], data_out[144], data_out[136],
          data_out[128], data_out[120], data_out[112], data_out[104], data_out[96],
          data_out[88], data_out[80], data_out[72], data_out[64], data_out[56], data_out[48],
          data_out[40], data_out[32], data_out[24], data_out[16], data_out[8], data_out[0]};
        shifted_readLatch0 = (readLatch0 >> A_int[3]);
        mem_path = {shifted_readLatch0[30], shifted_readLatch0[28], shifted_readLatch0[26],
          shifted_readLatch0[24], shifted_readLatch0[22], shifted_readLatch0[20], shifted_readLatch0[18],
          shifted_readLatch0[16], shifted_readLatch0[14], shifted_readLatch0[12], shifted_readLatch0[10],
          shifted_readLatch0[8], shifted_readLatch0[6], shifted_readLatch0[4], shifted_readLatch0[2],
          shifted_readLatch0[0]};
        	XQ = 1'b0; Q_update = 1'b1;
      end
      if (DFTRAMBYP_int === 1'b1) begin
        	XQ = 1'b0; Q_update = 1'b1;
      end
      if( isBitX(GWEN_int) && DFTRAMBYP_int !== 1'b1) begin
        XQ = 1'b1; Q_update = 1'b1;
      end
      if( isBitX(DFTRAMBYP_int) ) begin
        XQ = 1'b1; Q_update = 1'b1;
      end
      if( isBitX(SE_int) && DFTRAMBYP_int === 1'b1 ) begin
        XQ = 1'b1; Q_update = 1'b1;
      end
    end
  end
  endtask
  always @ (CEN_ or TCEN_ or TEN_ or DFTRAMBYP_ or CLK_) begin
  	if(CLK_ == 1'b0) begin
  		CEN_p2 = CEN_;
  		TCEN_p2 = TCEN_;
  		DFTRAMBYP_p2 = DFTRAMBYP_;
  	end
  end

`ifdef POWER_PINS
  always @ (VDDCE) begin
      if (VDDCE != 1'b1) begin
       if (VDDPE == 1'b1) begin
        $display("VDDCE should be powered down after VDDPE, Illegal power down sequencing in %m at %0t", $time);
       end
        $display("In PowerDown Mode in %m at %0t", $time);
        failedWrite(0);
      end
      if (VDDCE == 1'b1) begin
       if (VDDPE == 1'b1) begin
        $display("VDDPE should be powered up after VDDCE in %m at %0t", $time);
        $display("Illegal power up sequencing in %m at %0t", $time);
       end
        failedWrite(0);
      end
  end
`endif
`ifdef POWER_PINS
  always @ (RET1N_ or VDDPE or VDDCE) begin
`else     
  always @ RET1N_ begin
`endif
`ifdef POWER_PINS
    if (RET1N_ == 1'b1 && RET1N_int == 1'b1 && VDDCE == 1'b1 && VDDPE == 1'b1 && pre_charge_st == 1'b1 && (CEN_ === 1'bx || TCEN_ === 1'bx || DFTRAMBYP_ === 1'bx || CLK_ === 1'bx)) begin
      failedWrite(0);
        XQ = 1'b1; Q_update = 1'b1;
    end
`else     
`endif
`ifdef POWER_PINS
`else     
      pre_charge_st = 0;
`endif
    if (RET1N_ === 1'bx || RET1N_ === 1'bz) begin
      failedWrite(0);
        XQ = 1'b1; Q_update = 1'b1;
    end else if (RET1N_ === 1'b0 && RET1N_int === 1'b1 && (CEN_p2 === 1'b0 || TCEN_p2 === 1'b0 || DFTRAMBYP_p2 === 1'b1)) begin
      failedWrite(0);
        XQ = 1'b1; Q_update = 1'b1;
    end else if (RET1N_ === 1'b1 && RET1N_int === 1'b0 && (CEN_p2 === 1'b0 || TCEN_p2 === 1'b0 || DFTRAMBYP_p2 === 1'b1)) begin
      failedWrite(0);
        XQ = 1'b1; Q_update = 1'b1;
    end
`ifdef POWER_PINS
    if (RET1N_ == 1'b0 && VDDCE == 1'b1 && VDDPE == 1'b1) begin
      pre_charge_st = 1;
    end else if (RET1N_ == 1'b0 && VDDPE == 1'b0) begin
      pre_charge_st = 0;
      if (VDDCE != 1'b1) begin
        failedWrite(0);
      end
`else     
    if (RET1N_ == 1'b0) begin
`endif
        XQ = 1'b1; Q_update = 1'b1;
      CEN_int = 1'bx;
      WEN_int = {16{1'bx}};
      A_int = {14{1'bx}};
      D_int = {16{1'bx}};
      EMA_int = {3{1'bx}};
      EMAW_int = {2{1'bx}};
      TEN_int = 1'bx;
      TCEN_int = 1'bx;
      TWEN_int = {16{1'bx}};
      TA_int = {14{1'bx}};
      TD_int = {16{1'bx}};
      GWEN_int = 1'bx;
      TGWEN_int = 1'bx;
      RET1N_int = 1'bx;
      SE_int = 1'bx;
      DFTRAMBYP_int = 1'bx;
`ifdef POWER_PINS
    end else if (RET1N_ == 1'b1 && VDDCE == 1'b1 && VDDPE == 1'b1 &&  pre_charge_st == 1'b1) begin
      pre_charge_st = 0;
    end else begin
      pre_charge_st = 0;
`else     
    end else begin
`endif
        XQ = 1'b1; Q_update = 1'b1;
      CEN_int = 1'bx;
      WEN_int = {16{1'bx}};
      A_int = {14{1'bx}};
      D_int = {16{1'bx}};
      EMA_int = {3{1'bx}};
      EMAW_int = {2{1'bx}};
      TEN_int = 1'bx;
      TCEN_int = 1'bx;
      TWEN_int = {16{1'bx}};
      TA_int = {14{1'bx}};
      TD_int = {16{1'bx}};
      GWEN_int = 1'bx;
      TGWEN_int = 1'bx;
      RET1N_int = 1'bx;
      SE_int = 1'bx;
      DFTRAMBYP_int = 1'bx;
    end
    RET1N_int = RET1N_;
    #0;
        Q_update = 1'b0;
  end


  always @ CLK_ begin
// If POWER_PINS is defined at Simulator Command Line, it selects the module definition with Power Ports
`ifdef POWER_PINS
    if (VDDCE === 1'bx || VDDCE === 1'bz)
      $display("Warning: Unknown value for VDDCE %b in %m at %0t", VDDCE, $time);
    if (VDDPE === 1'bx || VDDPE === 1'bz)
      $display("Warning: Unknown value for VDDPE %b in %m at %0t", VDDPE, $time);
    if (VSSE === 1'bx || VSSE === 1'bz)
      $display("Warning: Unknown value for VSSE %b in %m at %0t", VSSE, $time);
`endif
`ifdef POWER_PINS
  if (RET1N_ == 1'b0) begin
`else     
  if (RET1N_ == 1'b0) begin
`endif
      // no cycle in retention mode
  end else begin
    if ((CLK_ === 1'bx || CLK_ === 1'bz) && RET1N_ !== 1'b0) begin
      failedWrite(0);
        XQ = 1'b1; Q_update = 1'b1;
    end else if ((CLK_ === 1'b1 || CLK_ === 1'b0) && LAST_CLK === 1'bx) begin
       D_sh_update = 1'b0;  XD_sh = 1'b0;
       XQ = 1'b0; Q_update = 1'b0; 
    end else if (CLK_ === 1'b1 && LAST_CLK === 1'b0) begin
      SE_int = SE_;
      DFTRAMBYP_int = DFTRAMBYP_;
      CEN_int = TEN_ ? CEN_ : TCEN_;
      EMA_int = EMA_;
      EMAW_int = EMAW_;
      TEN_int = TEN_;
      TWEN_int = TWEN_;
      RET1N_int = RET1N_;
      if (DFTRAMBYP_=== 1'b1 || CEN_int != 1'b1) begin
        WEN_int = TEN_ ? WEN_ : TWEN_;
        A_int = TEN_ ? A_ : TA_;
        D_int = TEN_ ? D_ : TD_;
        TCEN_int = TCEN_;
        TA_int = TA_;
        TD_int = TD_;
        GWEN_int = TEN_ ? GWEN_ : TGWEN_;
        TGWEN_int = TGWEN_;
        DFTRAMBYP_int = DFTRAMBYP_;
        if (GWEN_int === 1'b1 || DFTRAMBYP_ == 1'b1) begin
          read_mux_sel0 = (TEN_ ? A_[3] : TA_[3] );
          read_mux_sel0_p2 = ((^read_mux_sel0 === 1'bx) && DFTRAMBYP_p2) ? {1{1'b0}} : read_mux_sel0;
        end
      end
      clk0_int = 1'b0;
      if (DFTRAMBYP_=== 1'b1 && SE_ === 1'b1) begin
         read_mux_sel0 = (TEN_ ? A_[3] : TA_[3] );
         read_mux_sel0_p2 = ((^read_mux_sel0 === 1'bx) && DFTRAMBYP_p2) ? {1{1'b0}} : read_mux_sel0;
        XQ = 1'b0; Q_update = 1'b1;
      end else begin
      CEN_int = TEN_ ? CEN_ : TCEN_;
      EMA_int = EMA_;
      EMAW_int = EMAW_;
      TEN_int = TEN_;
      TWEN_int = TWEN_;
      RET1N_int = RET1N_;
      if (DFTRAMBYP_=== 1'b1 || CEN_int != 1'b1) begin
        WEN_int = TEN_ ? WEN_ : TWEN_;
        A_int = TEN_ ? A_ : TA_;
        D_int = TEN_ ? D_ : TD_;
        TCEN_int = TCEN_;
        TA_int = TA_;
        TD_int = TD_;
        GWEN_int = TEN_ ? GWEN_ : TGWEN_;
        TGWEN_int = TGWEN_;
        DFTRAMBYP_int = DFTRAMBYP_;
        if (GWEN_int === 1'b1 || DFTRAMBYP_ == 1'b1) begin
          read_mux_sel0 = (TEN_ ? A_[3] : TA_[3] );
          read_mux_sel0_p2 = ((^read_mux_sel0 === 1'bx) && DFTRAMBYP_p2) ? {1{1'b0}} : read_mux_sel0;
        end
      end
      clk0_int = 1'b0;
    readWrite;
      end
    end else if (CLK_ === 1'b0 && LAST_CLK === 1'b1) begin
      Q_update = 1'b0;
      D_sh_update = 1'b0;
      XQ = 1'b0;
         read_mux_sel0_p2 = ((^read_mux_sel0 === 1'bx) && DFTRAMBYP_p2) ? {1{1'b0}} : read_mux_sel0;
    end
  end
    LAST_CLK = CLK_;
  end

  assign SI_int = SE_ ? SI_ : {2{1'b0}};
  assign D_int_bmux = TEN_ ? D_ : TD_;

  datapath_latch_mem16384x16 uDQ0 (.CLK(CLK), .Q_update(Q_update), .D_update(D_sh_update), .SE(SE_), .SI(SI_int[0]), .D(D_int_bmux[0]), .DFTRAMBYP(DFTRAMBYP_), .mem_path(mem_path[0]), .XQ(XQ), .Q(Q_int[0]));
  datapath_latch_mem16384x16 uDQ1 (.CLK(CLK), .Q_update(Q_update), .D_update(D_sh_update), .SE(SE_), .SI(Q_int[0]), .D(D_int_bmux[1]), .DFTRAMBYP(DFTRAMBYP_), .mem_path(mem_path[1]), .XQ(XQ), .Q(Q_int[1]));
  datapath_latch_mem16384x16 uDQ2 (.CLK(CLK), .Q_update(Q_update), .D_update(D_sh_update), .SE(SE_), .SI(Q_int[1]), .D(D_int_bmux[2]), .DFTRAMBYP(DFTRAMBYP_), .mem_path(mem_path[2]), .XQ(XQ), .Q(Q_int[2]));
  datapath_latch_mem16384x16 uDQ3 (.CLK(CLK), .Q_update(Q_update), .D_update(D_sh_update), .SE(SE_), .SI(Q_int[2]), .D(D_int_bmux[3]), .DFTRAMBYP(DFTRAMBYP_), .mem_path(mem_path[3]), .XQ(XQ), .Q(Q_int[3]));
  datapath_latch_mem16384x16 uDQ4 (.CLK(CLK), .Q_update(Q_update), .D_update(D_sh_update), .SE(SE_), .SI(Q_int[3]), .D(D_int_bmux[4]), .DFTRAMBYP(DFTRAMBYP_), .mem_path(mem_path[4]), .XQ(XQ), .Q(Q_int[4]));
  datapath_latch_mem16384x16 uDQ5 (.CLK(CLK), .Q_update(Q_update), .D_update(D_sh_update), .SE(SE_), .SI(Q_int[4]), .D(D_int_bmux[5]), .DFTRAMBYP(DFTRAMBYP_), .mem_path(mem_path[5]), .XQ(XQ), .Q(Q_int[5]));
  datapath_latch_mem16384x16 uDQ6 (.CLK(CLK), .Q_update(Q_update), .D_update(D_sh_update), .SE(SE_), .SI(Q_int[5]), .D(D_int_bmux[6]), .DFTRAMBYP(DFTRAMBYP_), .mem_path(mem_path[6]), .XQ(XQ), .Q(Q_int[6]));
  datapath_latch_mem16384x16 uDQ7 (.CLK(CLK), .Q_update(Q_update), .D_update(D_sh_update), .SE(SE_), .SI(Q_int[6]), .D(D_int_bmux[7]), .DFTRAMBYP(DFTRAMBYP_), .mem_path(mem_path[7]), .XQ(XQ), .Q(Q_int[7]));
  datapath_latch_mem16384x16 uDQ8 (.CLK(CLK), .Q_update(Q_update), .D_update(D_sh_update), .SE(SE_), .SI(Q_int[9]), .D(D_int_bmux[8]), .DFTRAMBYP(DFTRAMBYP_), .mem_path(mem_path[8]), .XQ(XQ), .Q(Q_int[8]));
  datapath_latch_mem16384x16 uDQ9 (.CLK(CLK), .Q_update(Q_update), .D_update(D_sh_update), .SE(SE_), .SI(Q_int[10]), .D(D_int_bmux[9]), .DFTRAMBYP(DFTRAMBYP_), .mem_path(mem_path[9]), .XQ(XQ), .Q(Q_int[9]));
  datapath_latch_mem16384x16 uDQ10 (.CLK(CLK), .Q_update(Q_update), .D_update(D_sh_update), .SE(SE_), .SI(Q_int[11]), .D(D_int_bmux[10]), .DFTRAMBYP(DFTRAMBYP_), .mem_path(mem_path[10]), .XQ(XQ), .Q(Q_int[10]));
  datapath_latch_mem16384x16 uDQ11 (.CLK(CLK), .Q_update(Q_update), .D_update(D_sh_update), .SE(SE_), .SI(Q_int[12]), .D(D_int_bmux[11]), .DFTRAMBYP(DFTRAMBYP_), .mem_path(mem_path[11]), .XQ(XQ), .Q(Q_int[11]));
  datapath_latch_mem16384x16 uDQ12 (.CLK(CLK), .Q_update(Q_update), .D_update(D_sh_update), .SE(SE_), .SI(Q_int[13]), .D(D_int_bmux[12]), .DFTRAMBYP(DFTRAMBYP_), .mem_path(mem_path[12]), .XQ(XQ), .Q(Q_int[12]));
  datapath_latch_mem16384x16 uDQ13 (.CLK(CLK), .Q_update(Q_update), .D_update(D_sh_update), .SE(SE_), .SI(Q_int[14]), .D(D_int_bmux[13]), .DFTRAMBYP(DFTRAMBYP_), .mem_path(mem_path[13]), .XQ(XQ), .Q(Q_int[13]));
  datapath_latch_mem16384x16 uDQ14 (.CLK(CLK), .Q_update(Q_update), .D_update(D_sh_update), .SE(SE_), .SI(Q_int[15]), .D(D_int_bmux[14]), .DFTRAMBYP(DFTRAMBYP_), .mem_path(mem_path[14]), .XQ(XQ), .Q(Q_int[14]));
  datapath_latch_mem16384x16 uDQ15 (.CLK(CLK), .Q_update(Q_update), .D_update(D_sh_update), .SE(SE_), .SI(SI_int[1]), .D(D_int_bmux[15]), .DFTRAMBYP(DFTRAMBYP_), .mem_path(mem_path[15]), .XQ(XQ), .Q(Q_int[15]));


// If POWER_PINS is defined at Simulator Command Line, it selects the module definition with Power Ports
`ifdef POWER_PINS
 always @ (VDDCE or VDDPE or VSSE) begin
    if (VDDCE === 1'bx || VDDCE === 1'bz)
      $display("Warning: Unknown value for VDDCE %b in %m at %0t", VDDCE, $time);
    if (VDDPE === 1'bx || VDDPE === 1'bz)
      $display("Warning: Unknown value for VDDPE %b in %m at %0t", VDDPE, $time);
    if (VSSE === 1'bx || VSSE === 1'bz)
      $display("Warning: Unknown value for VSSE %b in %m at %0t", VSSE, $time);
 end
`endif

endmodule
`endcelldefine
`else
`celldefine
// If POWER_PINS is defined at Simulator Command Line, it selects the module definition with Power Ports
`ifdef POWER_PINS
module mem16384x16 (VDDCE, VDDPE, VSSE, CENY, WENY, AY, GWENY, Q, SO, CLK, CEN, WEN,
    A, D, EMA, EMAW, TEN, TCEN, TWEN, TA, TD, GWEN, TGWEN, RET1N, SI, SE, DFTRAMBYP);
`else
module mem16384x16 (CENY, WENY, AY, GWENY, Q, SO, CLK, CEN, WEN, A, D, EMA, EMAW, TEN,
    TCEN, TWEN, TA, TD, GWEN, TGWEN, RET1N, SI, SE, DFTRAMBYP);
`endif

  parameter ASSERT_PREFIX = "";
  parameter BITS = 16;
  parameter WORDS = 16384;
  parameter MUX = 16;
  parameter MEM_WIDTH = 256; // redun block size 8, 128 on left, 128 on right
  parameter MEM_HEIGHT = 1024;
  parameter WP_SIZE = 1 ;
  parameter UPM_WIDTH = 3;
  parameter UPMW_WIDTH = 2;
  parameter UPMS_WIDTH = 0;

  output  CENY;
  output [15:0] WENY;
  output [13:0] AY;
  output  GWENY;
  output [15:0] Q;
  output [1:0] SO;
  input  CLK;
  input  CEN;
  input [15:0] WEN;
  input [13:0] A;
  input [15:0] D;
  input [2:0] EMA;
  input [1:0] EMAW;
  input  TEN;
  input  TCEN;
  input [15:0] TWEN;
  input [13:0] TA;
  input [15:0] TD;
  input  GWEN;
  input  TGWEN;
  input  RET1N;
  input [1:0] SI;
  input  SE;
  input  DFTRAMBYP;
`ifdef POWER_PINS
  inout VDDCE;
  inout VDDPE;
  inout VSSE;
`endif

  reg pre_charge_st;
  integer row_address;
  integer mux_address;
  reg [255:0] mem [0:1023];
  reg [255:0] row, row_t;
  reg LAST_CLK;
  reg [255:0] row_mask;
  reg [255:0] new_data;
  reg [255:0] data_out;
  reg [31:0] readLatch0;
  reg [31:0] shifted_readLatch0;
  reg  read_mux_sel0;
  reg  read_mux_sel0_p2;
  wire [15:0] Q_int;
  reg XQ, Q_update;
  reg XD_sh, D_sh_update;
  wire [15:0] D_int_bmux;
  reg [15:0] mem_path;
  reg [15:0] writeEnable;

  reg NOT_CEN, NOT_WEN15, NOT_WEN14, NOT_WEN13, NOT_WEN12, NOT_WEN11, NOT_WEN10, NOT_WEN9;
  reg NOT_WEN8, NOT_WEN7, NOT_WEN6, NOT_WEN5, NOT_WEN4, NOT_WEN3, NOT_WEN2, NOT_WEN1;
  reg NOT_WEN0, NOT_A13, NOT_A12, NOT_A11, NOT_A10, NOT_A9, NOT_A8, NOT_A7, NOT_A6;
  reg NOT_A5, NOT_A4, NOT_A3, NOT_A2, NOT_A1, NOT_A0, NOT_D15, NOT_D14, NOT_D13, NOT_D12;
  reg NOT_D11, NOT_D10, NOT_D9, NOT_D8, NOT_D7, NOT_D6, NOT_D5, NOT_D4, NOT_D3, NOT_D2;
  reg NOT_D1, NOT_D0, NOT_EMA2, NOT_EMA1, NOT_EMA0, NOT_EMAW1, NOT_EMAW0, NOT_TEN;
  reg NOT_TCEN, NOT_TWEN15, NOT_TWEN14, NOT_TWEN13, NOT_TWEN12, NOT_TWEN11, NOT_TWEN10;
  reg NOT_TWEN9, NOT_TWEN8, NOT_TWEN7, NOT_TWEN6, NOT_TWEN5, NOT_TWEN4, NOT_TWEN3;
  reg NOT_TWEN2, NOT_TWEN1, NOT_TWEN0, NOT_TA13, NOT_TA12, NOT_TA11, NOT_TA10, NOT_TA9;
  reg NOT_TA8, NOT_TA7, NOT_TA6, NOT_TA5, NOT_TA4, NOT_TA3, NOT_TA2, NOT_TA1, NOT_TA0;
  reg NOT_TD15, NOT_TD14, NOT_TD13, NOT_TD12, NOT_TD11, NOT_TD10, NOT_TD9, NOT_TD8;
  reg NOT_TD7, NOT_TD6, NOT_TD5, NOT_TD4, NOT_TD3, NOT_TD2, NOT_TD1, NOT_TD0, NOT_GWEN;
  reg NOT_TGWEN, NOT_SI1, NOT_SI0, NOT_SE, NOT_DFTRAMBYP, NOT_RET1N;
  reg NOT_CLK_PER, NOT_CLK_MINH, NOT_CLK_MINL;
  reg clk0_int;

  wire  CENY_;
  wire [15:0] WENY_;
  wire [13:0] AY_;
  wire  GWENY_;
  wire [15:0] Q_;
  wire [1:0] SO_;
 wire  CLK_;
  wire  CEN_;
  reg  CEN_int;
  reg  CEN_p2;
  wire [15:0] WEN_;
  reg [15:0] WEN_int;
  wire [13:0] A_;
  reg [13:0] A_int;
  wire [15:0] D_;
  reg [15:0] D_int;
  wire [2:0] EMA_;
  reg [2:0] EMA_int;
  wire [1:0] EMAW_;
  reg [1:0] EMAW_int;
  wire  TEN_;
  reg  TEN_int;
  wire  TCEN_;
  reg  TCEN_int;
  reg  TCEN_p2;
  wire [15:0] TWEN_;
  reg [15:0] TWEN_int;
  wire [13:0] TA_;
  reg [13:0] TA_int;
  wire [15:0] TD_;
  reg [15:0] TD_int;
  wire  GWEN_;
  reg  GWEN_int;
  wire  TGWEN_;
  reg  TGWEN_int;
  wire  RET1N_;
  reg  RET1N_int;
  wire [1:0] SI_;
  wire [1:0] SI_int;
  wire  SE_;
  reg  SE_int;
  wire  DFTRAMBYP_;
  reg  DFTRAMBYP_int;
  reg  DFTRAMBYP_p2;

  buf B0(CENY, CENY_);
  buf B1(WENY[0], WENY_[0]);
  buf B2(WENY[1], WENY_[1]);
  buf B3(WENY[2], WENY_[2]);
  buf B4(WENY[3], WENY_[3]);
  buf B5(WENY[4], WENY_[4]);
  buf B6(WENY[5], WENY_[5]);
  buf B7(WENY[6], WENY_[6]);
  buf B8(WENY[7], WENY_[7]);
  buf B9(WENY[8], WENY_[8]);
  buf B10(WENY[9], WENY_[9]);
  buf B11(WENY[10], WENY_[10]);
  buf B12(WENY[11], WENY_[11]);
  buf B13(WENY[12], WENY_[12]);
  buf B14(WENY[13], WENY_[13]);
  buf B15(WENY[14], WENY_[14]);
  buf B16(WENY[15], WENY_[15]);
  buf B17(AY[0], AY_[0]);
  buf B18(AY[1], AY_[1]);
  buf B19(AY[2], AY_[2]);
  buf B20(AY[3], AY_[3]);
  buf B21(AY[4], AY_[4]);
  buf B22(AY[5], AY_[5]);
  buf B23(AY[6], AY_[6]);
  buf B24(AY[7], AY_[7]);
  buf B25(AY[8], AY_[8]);
  buf B26(AY[9], AY_[9]);
  buf B27(AY[10], AY_[10]);
  buf B28(AY[11], AY_[11]);
  buf B29(AY[12], AY_[12]);
  buf B30(AY[13], AY_[13]);
  buf B31(GWENY, GWENY_);
  buf B32(Q[0], Q_[0]);
  buf B33(Q[1], Q_[1]);
  buf B34(Q[2], Q_[2]);
  buf B35(Q[3], Q_[3]);
  buf B36(Q[4], Q_[4]);
  buf B37(Q[5], Q_[5]);
  buf B38(Q[6], Q_[6]);
  buf B39(Q[7], Q_[7]);
  buf B40(Q[8], Q_[8]);
  buf B41(Q[9], Q_[9]);
  buf B42(Q[10], Q_[10]);
  buf B43(Q[11], Q_[11]);
  buf B44(Q[12], Q_[12]);
  buf B45(Q[13], Q_[13]);
  buf B46(Q[14], Q_[14]);
  buf B47(Q[15], Q_[15]);
  buf B48(SO[0], SO_[0]);
  buf B49(SO[1], SO_[1]);
  buf B50(CLK_, CLK);
  buf B51(CEN_, CEN);
  buf B52(WEN_[0], WEN[0]);
  buf B53(WEN_[1], WEN[1]);
  buf B54(WEN_[2], WEN[2]);
  buf B55(WEN_[3], WEN[3]);
  buf B56(WEN_[4], WEN[4]);
  buf B57(WEN_[5], WEN[5]);
  buf B58(WEN_[6], WEN[6]);
  buf B59(WEN_[7], WEN[7]);
  buf B60(WEN_[8], WEN[8]);
  buf B61(WEN_[9], WEN[9]);
  buf B62(WEN_[10], WEN[10]);
  buf B63(WEN_[11], WEN[11]);
  buf B64(WEN_[12], WEN[12]);
  buf B65(WEN_[13], WEN[13]);
  buf B66(WEN_[14], WEN[14]);
  buf B67(WEN_[15], WEN[15]);
  buf B68(A_[0], A[0]);
  buf B69(A_[1], A[1]);
  buf B70(A_[2], A[2]);
  buf B71(A_[3], A[3]);
  buf B72(A_[4], A[4]);
  buf B73(A_[5], A[5]);
  buf B74(A_[6], A[6]);
  buf B75(A_[7], A[7]);
  buf B76(A_[8], A[8]);
  buf B77(A_[9], A[9]);
  buf B78(A_[10], A[10]);
  buf B79(A_[11], A[11]);
  buf B80(A_[12], A[12]);
  buf B81(A_[13], A[13]);
  buf B82(D_[0], D[0]);
  buf B83(D_[1], D[1]);
  buf B84(D_[2], D[2]);
  buf B85(D_[3], D[3]);
  buf B86(D_[4], D[4]);
  buf B87(D_[5], D[5]);
  buf B88(D_[6], D[6]);
  buf B89(D_[7], D[7]);
  buf B90(D_[8], D[8]);
  buf B91(D_[9], D[9]);
  buf B92(D_[10], D[10]);
  buf B93(D_[11], D[11]);
  buf B94(D_[12], D[12]);
  buf B95(D_[13], D[13]);
  buf B96(D_[14], D[14]);
  buf B97(D_[15], D[15]);
  buf B98(EMA_[0], EMA[0]);
  buf B99(EMA_[1], EMA[1]);
  buf B100(EMA_[2], EMA[2]);
  buf B101(EMAW_[0], EMAW[0]);
  buf B102(EMAW_[1], EMAW[1]);
  buf B103(TEN_, TEN);
  buf B104(TCEN_, TCEN);
  buf B105(TWEN_[0], TWEN[0]);
  buf B106(TWEN_[1], TWEN[1]);
  buf B107(TWEN_[2], TWEN[2]);
  buf B108(TWEN_[3], TWEN[3]);
  buf B109(TWEN_[4], TWEN[4]);
  buf B110(TWEN_[5], TWEN[5]);
  buf B111(TWEN_[6], TWEN[6]);
  buf B112(TWEN_[7], TWEN[7]);
  buf B113(TWEN_[8], TWEN[8]);
  buf B114(TWEN_[9], TWEN[9]);
  buf B115(TWEN_[10], TWEN[10]);
  buf B116(TWEN_[11], TWEN[11]);
  buf B117(TWEN_[12], TWEN[12]);
  buf B118(TWEN_[13], TWEN[13]);
  buf B119(TWEN_[14], TWEN[14]);
  buf B120(TWEN_[15], TWEN[15]);
  buf B121(TA_[0], TA[0]);
  buf B122(TA_[1], TA[1]);
  buf B123(TA_[2], TA[2]);
  buf B124(TA_[3], TA[3]);
  buf B125(TA_[4], TA[4]);
  buf B126(TA_[5], TA[5]);
  buf B127(TA_[6], TA[6]);
  buf B128(TA_[7], TA[7]);
  buf B129(TA_[8], TA[8]);
  buf B130(TA_[9], TA[9]);
  buf B131(TA_[10], TA[10]);
  buf B132(TA_[11], TA[11]);
  buf B133(TA_[12], TA[12]);
  buf B134(TA_[13], TA[13]);
  buf B135(TD_[0], TD[0]);
  buf B136(TD_[1], TD[1]);
  buf B137(TD_[2], TD[2]);
  buf B138(TD_[3], TD[3]);
  buf B139(TD_[4], TD[4]);
  buf B140(TD_[5], TD[5]);
  buf B141(TD_[6], TD[6]);
  buf B142(TD_[7], TD[7]);
  buf B143(TD_[8], TD[8]);
  buf B144(TD_[9], TD[9]);
  buf B145(TD_[10], TD[10]);
  buf B146(TD_[11], TD[11]);
  buf B147(TD_[12], TD[12]);
  buf B148(TD_[13], TD[13]);
  buf B149(TD_[14], TD[14]);
  buf B150(TD_[15], TD[15]);
  buf B151(GWEN_, GWEN);
  buf B152(TGWEN_, TGWEN);
  buf B153(RET1N_, RET1N);
  buf B154(SI_[0], SI[0]);
  buf B155(SI_[1], SI[1]);
  buf B156(SE_, SE);
  buf B157(DFTRAMBYP_, DFTRAMBYP);

  assign CENY_ = (RET1N_ | pre_charge_st) ? (DFTRAMBYP_ & (TEN_ ? CEN_ : TCEN_)) : 1'bx;
  assign WENY_ = (RET1N_ | pre_charge_st) ? ({16{DFTRAMBYP_}} & (TEN_ ? WEN_ : TWEN_)) : {16{1'bx}};
  assign AY_ = (RET1N_ | pre_charge_st) ? ({14{DFTRAMBYP_}} & (TEN_ ? A_ : TA_)) : {14{1'bx}};
  assign GWENY_ = (RET1N_ | pre_charge_st) ? (DFTRAMBYP_ & (TEN_ ? GWEN_ : TGWEN_)) : 1'bx;
  assign Q_ = (RET1N_ | pre_charge_st) ? ((Q_int)) : {16{1'bx}};
  assign SO_ = (RET1N_ | pre_charge_st) ? ({Q_[8], Q_[7]}) : {2{1'bx}};

// If INITIALIZE_MEMORY is defined at Simulator Command Line, it Initializes the Memory with all ZEROS.
`ifdef INITIALIZE_MEMORY
  integer i;
  initial begin
    #0;
    for (i = 0; i < MEM_HEIGHT; i = i + 1)
      mem[i] = {MEM_WIDTH{1'b0}};
  end
`endif
  always @ (EMA_) begin
  	if(EMA_ < 2) 
   	$display("Warning: Set Value for EMA doesn't match Default value 2 in %m at %0t", $time);
  end
  always @ (EMAW_) begin
  	if(EMAW_ < 0) 
   	$display("Warning: Set Value for EMAW doesn't match Default value 0 in %m at %0t", $time);
  end

  task failedWrite;
  input port_f;
  integer i;
  begin
    for (i = 0; i < MEM_HEIGHT; i = i + 1)
      mem[i] = {MEM_WIDTH{1'bx}};
  end
  endtask

  function isBitX;
    input bitval;
    begin
      isBitX = ( bitval===1'bx || bitval==1'bz ) ? 1'b1 : 1'b0;
    end
  endfunction

  function isBit1;
    input bitval;
    begin
      isBit1 = ( bitval===1'b1 ) ? 1'b1 : 1'b0;
    end
  endfunction



  task readWrite;
  begin
    if (GWEN_int !== 1'b1 && DFTRAMBYP_int=== 1'b0 && SE_int === 1'bx) begin
      failedWrite(0);
    end else if (DFTRAMBYP_int=== 1'b0 && SE_int === 1'b1) begin
      failedWrite(0);
        XQ = 1'b1; Q_update = 1'b1;
    end else if (RET1N_int === 1'bx || RET1N_int === 1'bz) begin
      failedWrite(0);
        XQ = 1'b1; Q_update = 1'b1;
    end else if (RET1N_int === 1'b0 && (CEN_int === 1'b0 || DFTRAMBYP_int === 1'b1)) begin
      failedWrite(0);
        XQ = 1'b1; Q_update = 1'b1;
    end else if (RET1N_int === 1'b0) begin
      // no cycle in retention mode
    end else if (^{(EMA_int & isBit1(DFTRAMBYP_int)), (EMAW_int & isBit1(DFTRAMBYP_int))} === 1'bx) begin
        XQ = 1'b1; Q_update = 1'b1;
    end else if (^{(CEN_int & !isBit1(DFTRAMBYP_int)), EMA_int, EMAW_int, RET1N_int} === 1'bx) begin
      failedWrite(0);
        XQ = 1'b1; Q_update = 1'b1;
    end else if ((A_int >= WORDS) && (CEN_int === 1'b0) && DFTRAMBYP_int === 1'b0) begin
        XQ = GWEN_int !== 1'b1 ? 1'b0 : 1'b1; Q_update = GWEN_int !== 1'b1 ? 1'b0 : 1'b1;
    end else if (CEN_int === 1'b0 && (^A_int) === 1'bx && DFTRAMBYP_int === 1'b0) begin
      failedWrite(0);
        XQ = 1'b1; Q_update = 1'b1;
    end else if (CEN_int === 1'b0 || DFTRAMBYP_int === 1'b1) begin
      if(isBitX(DFTRAMBYP_int) || isBitX(SE_int))
        D_int = {16{1'bx}};

      mux_address = (A_int & 4'b1111);
      row_address = (A_int >> 4);
      if (DFTRAMBYP_int !== 1'b1) begin
      if (row_address > 1023)
        row = {256{1'bx}};
      else
        row = mem[row_address];
      end
      if( (isBitX(GWEN_int) && DFTRAMBYP_int!==1) || isBitX(DFTRAMBYP_int) ) begin
        writeEnable = {16{1'bx}};
        D_int = {16{1'bx}};
      end else
          writeEnable = ~ ( {16{GWEN_int}} | {WEN_int[15], WEN_int[14], WEN_int[13],
          WEN_int[12], WEN_int[11], WEN_int[10], WEN_int[9], WEN_int[8], WEN_int[7],
          WEN_int[6], WEN_int[5], WEN_int[4], WEN_int[3], WEN_int[2], WEN_int[1], WEN_int[0]});
      if (GWEN_int !== 1'b1 || DFTRAMBYP_int === 1'b1 || DFTRAMBYP_int === 1'bx) begin
        row_mask =  ( {15'b000000000000000, writeEnable[15], 15'b000000000000000, writeEnable[14],
          15'b000000000000000, writeEnable[13], 15'b000000000000000, writeEnable[12],
          15'b000000000000000, writeEnable[11], 15'b000000000000000, writeEnable[10],
          15'b000000000000000, writeEnable[9], 15'b000000000000000, writeEnable[8],
          15'b000000000000000, writeEnable[7], 15'b000000000000000, writeEnable[6],
          15'b000000000000000, writeEnable[5], 15'b000000000000000, writeEnable[4],
          15'b000000000000000, writeEnable[3], 15'b000000000000000, writeEnable[2],
          15'b000000000000000, writeEnable[1], 15'b000000000000000, writeEnable[0]} << mux_address);
        new_data =  ( {15'b000000000000000, D_int[15], 15'b000000000000000, D_int[14],
          15'b000000000000000, D_int[13], 15'b000000000000000, D_int[12], 15'b000000000000000, D_int[11],
          15'b000000000000000, D_int[10], 15'b000000000000000, D_int[9], 15'b000000000000000, D_int[8],
          15'b000000000000000, D_int[7], 15'b000000000000000, D_int[6], 15'b000000000000000, D_int[5],
          15'b000000000000000, D_int[4], 15'b000000000000000, D_int[3], 15'b000000000000000, D_int[2],
          15'b000000000000000, D_int[1], 15'b000000000000000, D_int[0]} << mux_address);
        row = (row & ~row_mask) | (row_mask & (~row_mask | new_data));
        if (DFTRAMBYP_int === 1'b1 && SE_int === 1'b0) begin
        end else if (GWEN_int !== 1'b1 && DFTRAMBYP_int === 1'b1 && SE_int === 1'bx) begin
        	XQ = 1'b1; Q_update = 1'b1;
        end else begin
        mem[row_address] = row;
        end
      end else begin
        data_out = (row >> (mux_address%8));
        readLatch0 = {data_out[248], data_out[240], data_out[232], data_out[224], data_out[216],
          data_out[208], data_out[200], data_out[192], data_out[184], data_out[176],
          data_out[168], data_out[160], data_out[152], data_out[144], data_out[136],
          data_out[128], data_out[120], data_out[112], data_out[104], data_out[96],
          data_out[88], data_out[80], data_out[72], data_out[64], data_out[56], data_out[48],
          data_out[40], data_out[32], data_out[24], data_out[16], data_out[8], data_out[0]};
        shifted_readLatch0 = (readLatch0 >> A_int[3]);
        mem_path = {shifted_readLatch0[30], shifted_readLatch0[28], shifted_readLatch0[26],
          shifted_readLatch0[24], shifted_readLatch0[22], shifted_readLatch0[20], shifted_readLatch0[18],
          shifted_readLatch0[16], shifted_readLatch0[14], shifted_readLatch0[12], shifted_readLatch0[10],
          shifted_readLatch0[8], shifted_readLatch0[6], shifted_readLatch0[4], shifted_readLatch0[2],
          shifted_readLatch0[0]};
        	XQ = 1'b0; Q_update = 1'b1;
      end
      if (DFTRAMBYP_int === 1'b1) begin
        	XQ = 1'b0; Q_update = 1'b1;
      end
      if( isBitX(GWEN_int) && DFTRAMBYP_int !== 1'b1) begin
        XQ = 1'b1; Q_update = 1'b1;
      end
      if( isBitX(DFTRAMBYP_int) ) begin
        XQ = 1'b1; Q_update = 1'b1;
      end
      if( isBitX(SE_int) && DFTRAMBYP_int === 1'b1 ) begin
        XQ = 1'b1; Q_update = 1'b1;
      end
    end
  end
  endtask
  always @ (CEN_ or TCEN_ or TEN_ or DFTRAMBYP_ or CLK_) begin
  	if(CLK_ == 1'b0) begin
  		CEN_p2 = CEN_;
  		TCEN_p2 = TCEN_;
  		DFTRAMBYP_p2 = DFTRAMBYP_;
  	end
  end

`ifdef POWER_PINS
  always @ (VDDCE) begin
      if (VDDCE != 1'b1) begin
       if (VDDPE == 1'b1) begin
        $display("VDDCE should be powered down after VDDPE, Illegal power down sequencing in %m at %0t", $time);
       end
        $display("In PowerDown Mode in %m at %0t", $time);
        failedWrite(0);
      end
      if (VDDCE == 1'b1) begin
       if (VDDPE == 1'b1) begin
        $display("VDDPE should be powered up after VDDCE in %m at %0t", $time);
        $display("Illegal power up sequencing in %m at %0t", $time);
       end
        failedWrite(0);
      end
  end
`endif
`ifdef POWER_PINS
  always @ (RET1N_ or VDDPE or VDDCE) begin
`else     
  always @ RET1N_ begin
`endif
`ifdef POWER_PINS
    if (RET1N_ == 1'b1 && RET1N_int == 1'b1 && VDDCE == 1'b1 && VDDPE == 1'b1 && pre_charge_st == 1'b1 && (CEN_ === 1'bx || TCEN_ === 1'bx || DFTRAMBYP_ === 1'bx || CLK_ === 1'bx)) begin
      failedWrite(0);
        XQ = 1'b1; Q_update = 1'b1;
    end
`else     
`endif
`ifdef POWER_PINS
`else     
      pre_charge_st = 0;
`endif
    if (RET1N_ === 1'bx || RET1N_ === 1'bz) begin
      failedWrite(0);
        XQ = 1'b1; Q_update = 1'b1;
    end else if (RET1N_ === 1'b0 && RET1N_int === 1'b1 && (CEN_p2 === 1'b0 || TCEN_p2 === 1'b0 || DFTRAMBYP_p2 === 1'b1)) begin
      failedWrite(0);
        XQ = 1'b1; Q_update = 1'b1;
    end else if (RET1N_ === 1'b1 && RET1N_int === 1'b0 && (CEN_p2 === 1'b0 || TCEN_p2 === 1'b0 || DFTRAMBYP_p2 === 1'b1)) begin
      failedWrite(0);
        XQ = 1'b1; Q_update = 1'b1;
    end
`ifdef POWER_PINS
    if (RET1N_ == 1'b0 && VDDCE == 1'b1 && VDDPE == 1'b1) begin
      pre_charge_st = 1;
    end else if (RET1N_ == 1'b0 && VDDPE == 1'b0) begin
      pre_charge_st = 0;
      if (VDDCE != 1'b1) begin
        failedWrite(0);
      end
`else     
    if (RET1N_ == 1'b0) begin
`endif
        XQ = 1'b1; Q_update = 1'b1;
      CEN_int = 1'bx;
      WEN_int = {16{1'bx}};
      A_int = {14{1'bx}};
      D_int = {16{1'bx}};
      EMA_int = {3{1'bx}};
      EMAW_int = {2{1'bx}};
      TEN_int = 1'bx;
      TCEN_int = 1'bx;
      TWEN_int = {16{1'bx}};
      TA_int = {14{1'bx}};
      TD_int = {16{1'bx}};
      GWEN_int = 1'bx;
      TGWEN_int = 1'bx;
      RET1N_int = 1'bx;
      SE_int = 1'bx;
      DFTRAMBYP_int = 1'bx;
`ifdef POWER_PINS
    end else if (RET1N_ == 1'b1 && VDDCE == 1'b1 && VDDPE == 1'b1 &&  pre_charge_st == 1'b1) begin
      pre_charge_st = 0;
    end else begin
      pre_charge_st = 0;
`else     
    end else begin
`endif
        XQ = 1'b1; Q_update = 1'b1;
      CEN_int = 1'bx;
      WEN_int = {16{1'bx}};
      A_int = {14{1'bx}};
      D_int = {16{1'bx}};
      EMA_int = {3{1'bx}};
      EMAW_int = {2{1'bx}};
      TEN_int = 1'bx;
      TCEN_int = 1'bx;
      TWEN_int = {16{1'bx}};
      TA_int = {14{1'bx}};
      TD_int = {16{1'bx}};
      GWEN_int = 1'bx;
      TGWEN_int = 1'bx;
      RET1N_int = 1'bx;
      SE_int = 1'bx;
      DFTRAMBYP_int = 1'bx;
    end
    RET1N_int = RET1N_;
    #0;
        Q_update = 1'b0;
  end


  always @ CLK_ begin
// If POWER_PINS is defined at Simulator Command Line, it selects the module definition with Power Ports
`ifdef POWER_PINS
    if (VDDCE === 1'bx || VDDCE === 1'bz)
      $display("Warning: Unknown value for VDDCE %b in %m at %0t", VDDCE, $time);
    if (VDDPE === 1'bx || VDDPE === 1'bz)
      $display("Warning: Unknown value for VDDPE %b in %m at %0t", VDDPE, $time);
    if (VSSE === 1'bx || VSSE === 1'bz)
      $display("Warning: Unknown value for VSSE %b in %m at %0t", VSSE, $time);
`endif
`ifdef POWER_PINS
  if (RET1N_ == 1'b0) begin
`else     
  if (RET1N_ == 1'b0) begin
`endif
      // no cycle in retention mode
  end else begin
    if ((CLK_ === 1'bx || CLK_ === 1'bz) && RET1N_ !== 1'b0) begin
      failedWrite(0);
        XQ = 1'b1; Q_update = 1'b1;
    end else if ((CLK_ === 1'b1 || CLK_ === 1'b0) && LAST_CLK === 1'bx) begin
       D_sh_update = 1'b0;  XD_sh = 1'b0;
       XQ = 1'b0; Q_update = 1'b0; 
    end else if (CLK_ === 1'b1 && LAST_CLK === 1'b0) begin
      SE_int = SE_;
      DFTRAMBYP_int = DFTRAMBYP_;
      CEN_int = TEN_ ? CEN_ : TCEN_;
      EMA_int = EMA_;
      EMAW_int = EMAW_;
      TEN_int = TEN_;
      TWEN_int = TWEN_;
      RET1N_int = RET1N_;
      if (DFTRAMBYP_=== 1'b1 || CEN_int != 1'b1) begin
        WEN_int = TEN_ ? WEN_ : TWEN_;
        A_int = TEN_ ? A_ : TA_;
        D_int = TEN_ ? D_ : TD_;
        TCEN_int = TCEN_;
        TA_int = TA_;
        TD_int = TD_;
        GWEN_int = TEN_ ? GWEN_ : TGWEN_;
        TGWEN_int = TGWEN_;
        DFTRAMBYP_int = DFTRAMBYP_;
        if (GWEN_int === 1'b1 || DFTRAMBYP_ == 1'b1) begin
          read_mux_sel0 = (TEN_ ? A_[3] : TA_[3] );
          read_mux_sel0_p2 = ((^read_mux_sel0 === 1'bx) && DFTRAMBYP_p2) ? {1{1'b0}} : read_mux_sel0;
        end
      end
      clk0_int = 1'b0;
      if (DFTRAMBYP_=== 1'b1 && SE_ === 1'b1) begin
         read_mux_sel0 = (TEN_ ? A_[3] : TA_[3] );
         read_mux_sel0_p2 = ((^read_mux_sel0 === 1'bx) && DFTRAMBYP_p2) ? {1{1'b0}} : read_mux_sel0;
        XQ = 1'b0; Q_update = 1'b1;
      end else begin
      CEN_int = TEN_ ? CEN_ : TCEN_;
      EMA_int = EMA_;
      EMAW_int = EMAW_;
      TEN_int = TEN_;
      TWEN_int = TWEN_;
      RET1N_int = RET1N_;
      if (DFTRAMBYP_=== 1'b1 || CEN_int != 1'b1) begin
        WEN_int = TEN_ ? WEN_ : TWEN_;
        A_int = TEN_ ? A_ : TA_;
        D_int = TEN_ ? D_ : TD_;
        TCEN_int = TCEN_;
        TA_int = TA_;
        TD_int = TD_;
        GWEN_int = TEN_ ? GWEN_ : TGWEN_;
        TGWEN_int = TGWEN_;
        DFTRAMBYP_int = DFTRAMBYP_;
        if (GWEN_int === 1'b1 || DFTRAMBYP_ == 1'b1) begin
          read_mux_sel0 = (TEN_ ? A_[3] : TA_[3] );
          read_mux_sel0_p2 = ((^read_mux_sel0 === 1'bx) && DFTRAMBYP_p2) ? {1{1'b0}} : read_mux_sel0;
        end
      end
      clk0_int = 1'b0;
    readWrite;
      end
    end else if (CLK_ === 1'b0 && LAST_CLK === 1'b1) begin
      Q_update = 1'b0;
      D_sh_update = 1'b0;
      XQ = 1'b0;
         read_mux_sel0_p2 = ((^read_mux_sel0 === 1'bx) && DFTRAMBYP_p2) ? {1{1'b0}} : read_mux_sel0;
    end
  end
    LAST_CLK = CLK_;
  end

  reg globalNotifier0;
  initial globalNotifier0 = 1'b0;

  always @ globalNotifier0 begin
    if ($realtime == 0) begin
    end else if ((EMAW_int[0] === 1'bx & DFTRAMBYP_int === 1'b1) || (EMAW_int[1] === 1'bx & DFTRAMBYP_int === 1'b1) || 
      (EMA_int[0] === 1'bx & DFTRAMBYP_int === 1'b1) || (EMA_int[1] === 1'bx & DFTRAMBYP_int === 1'b1) || 
      (EMA_int[2] === 1'bx & DFTRAMBYP_int === 1'b1)) begin
        XQ = 1'b1; Q_update = 1'b1;
    end else if ((CEN_int === 1'bx & DFTRAMBYP_int === 1'b0) || EMAW_int[0] === 1'bx || 
      EMAW_int[1] === 1'bx || EMA_int[0] === 1'bx || EMA_int[1] === 1'bx || EMA_int[2] === 1'bx || 
      RET1N_int === 1'bx || clk0_int === 1'bx) begin
        XQ = 1'b1; Q_update = 1'b1;
      failedWrite(0);
    end else if (TEN_int === 1'bx) begin
      if(((CEN_ === 1'b1 & TCEN_ === 1'b1) & DFTRAMBYP_int === 1'b0) | (DFTRAMBYP_int === 1'b1 & SE_int === 1'b1)) begin
      end else begin
        XQ = 1'b1; Q_update = 1'b1;
      if (DFTRAMBYP_int === 1'b0) begin
          failedWrite(0);
      end
      end
    end else begin
      #0;
      readWrite;
   end
      #0;
        XQ = 1'b0; Q_update = 1'b0;
    globalNotifier0 = 1'b0;
  end

  assign SI_int = SE_ ? SI_ : {2{1'b0}};
  assign D_int_bmux = TEN_ ? D_ : TD_;

  datapath_latch_mem16384x16 uDQ0 (.CLK(CLK), .Q_update(Q_update), .D_update(D_sh_update), .SE(SE_), .SI(SI_int[0]), .D(D_int_bmux[0]), .DFTRAMBYP(DFTRAMBYP_), .mem_path(mem_path[0]), .XQ(XQ), .Q(Q_int[0]));
  datapath_latch_mem16384x16 uDQ1 (.CLK(CLK), .Q_update(Q_update), .D_update(D_sh_update), .SE(SE_), .SI(Q_int[0]), .D(D_int_bmux[1]), .DFTRAMBYP(DFTRAMBYP_), .mem_path(mem_path[1]), .XQ(XQ), .Q(Q_int[1]));
  datapath_latch_mem16384x16 uDQ2 (.CLK(CLK), .Q_update(Q_update), .D_update(D_sh_update), .SE(SE_), .SI(Q_int[1]), .D(D_int_bmux[2]), .DFTRAMBYP(DFTRAMBYP_), .mem_path(mem_path[2]), .XQ(XQ), .Q(Q_int[2]));
  datapath_latch_mem16384x16 uDQ3 (.CLK(CLK), .Q_update(Q_update), .D_update(D_sh_update), .SE(SE_), .SI(Q_int[2]), .D(D_int_bmux[3]), .DFTRAMBYP(DFTRAMBYP_), .mem_path(mem_path[3]), .XQ(XQ), .Q(Q_int[3]));
  datapath_latch_mem16384x16 uDQ4 (.CLK(CLK), .Q_update(Q_update), .D_update(D_sh_update), .SE(SE_), .SI(Q_int[3]), .D(D_int_bmux[4]), .DFTRAMBYP(DFTRAMBYP_), .mem_path(mem_path[4]), .XQ(XQ), .Q(Q_int[4]));
  datapath_latch_mem16384x16 uDQ5 (.CLK(CLK), .Q_update(Q_update), .D_update(D_sh_update), .SE(SE_), .SI(Q_int[4]), .D(D_int_bmux[5]), .DFTRAMBYP(DFTRAMBYP_), .mem_path(mem_path[5]), .XQ(XQ), .Q(Q_int[5]));
  datapath_latch_mem16384x16 uDQ6 (.CLK(CLK), .Q_update(Q_update), .D_update(D_sh_update), .SE(SE_), .SI(Q_int[5]), .D(D_int_bmux[6]), .DFTRAMBYP(DFTRAMBYP_), .mem_path(mem_path[6]), .XQ(XQ), .Q(Q_int[6]));
  datapath_latch_mem16384x16 uDQ7 (.CLK(CLK), .Q_update(Q_update), .D_update(D_sh_update), .SE(SE_), .SI(Q_int[6]), .D(D_int_bmux[7]), .DFTRAMBYP(DFTRAMBYP_), .mem_path(mem_path[7]), .XQ(XQ), .Q(Q_int[7]));
  datapath_latch_mem16384x16 uDQ8 (.CLK(CLK), .Q_update(Q_update), .D_update(D_sh_update), .SE(SE_), .SI(Q_int[9]), .D(D_int_bmux[8]), .DFTRAMBYP(DFTRAMBYP_), .mem_path(mem_path[8]), .XQ(XQ), .Q(Q_int[8]));
  datapath_latch_mem16384x16 uDQ9 (.CLK(CLK), .Q_update(Q_update), .D_update(D_sh_update), .SE(SE_), .SI(Q_int[10]), .D(D_int_bmux[9]), .DFTRAMBYP(DFTRAMBYP_), .mem_path(mem_path[9]), .XQ(XQ), .Q(Q_int[9]));
  datapath_latch_mem16384x16 uDQ10 (.CLK(CLK), .Q_update(Q_update), .D_update(D_sh_update), .SE(SE_), .SI(Q_int[11]), .D(D_int_bmux[10]), .DFTRAMBYP(DFTRAMBYP_), .mem_path(mem_path[10]), .XQ(XQ), .Q(Q_int[10]));
  datapath_latch_mem16384x16 uDQ11 (.CLK(CLK), .Q_update(Q_update), .D_update(D_sh_update), .SE(SE_), .SI(Q_int[12]), .D(D_int_bmux[11]), .DFTRAMBYP(DFTRAMBYP_), .mem_path(mem_path[11]), .XQ(XQ), .Q(Q_int[11]));
  datapath_latch_mem16384x16 uDQ12 (.CLK(CLK), .Q_update(Q_update), .D_update(D_sh_update), .SE(SE_), .SI(Q_int[13]), .D(D_int_bmux[12]), .DFTRAMBYP(DFTRAMBYP_), .mem_path(mem_path[12]), .XQ(XQ), .Q(Q_int[12]));
  datapath_latch_mem16384x16 uDQ13 (.CLK(CLK), .Q_update(Q_update), .D_update(D_sh_update), .SE(SE_), .SI(Q_int[14]), .D(D_int_bmux[13]), .DFTRAMBYP(DFTRAMBYP_), .mem_path(mem_path[13]), .XQ(XQ), .Q(Q_int[13]));
  datapath_latch_mem16384x16 uDQ14 (.CLK(CLK), .Q_update(Q_update), .D_update(D_sh_update), .SE(SE_), .SI(Q_int[15]), .D(D_int_bmux[14]), .DFTRAMBYP(DFTRAMBYP_), .mem_path(mem_path[14]), .XQ(XQ), .Q(Q_int[14]));
  datapath_latch_mem16384x16 uDQ15 (.CLK(CLK), .Q_update(Q_update), .D_update(D_sh_update), .SE(SE_), .SI(SI_int[1]), .D(D_int_bmux[15]), .DFTRAMBYP(DFTRAMBYP_), .mem_path(mem_path[15]), .XQ(XQ), .Q(Q_int[15]));


// If POWER_PINS is defined at Simulator Command Line, it selects the module definition with Power Ports
`ifdef POWER_PINS
 always @ (VDDCE or VDDPE or VSSE) begin
    if (VDDCE === 1'bx || VDDCE === 1'bz)
      $display("Warning: Unknown value for VDDCE %b in %m at %0t", VDDCE, $time);
    if (VDDPE === 1'bx || VDDPE === 1'bz)
      $display("Warning: Unknown value for VDDPE %b in %m at %0t", VDDPE, $time);
    if (VSSE === 1'bx || VSSE === 1'bz)
      $display("Warning: Unknown value for VSSE %b in %m at %0t", VSSE, $time);
 end
`endif

  always @ NOT_CEN begin
    CEN_int = 1'bx;
    if ( globalNotifier0 === 1'b0 ) globalNotifier0 = 1'bx;
  end
  always @ NOT_WEN15 begin
    WEN_int[15] = 1'bx;
    if ( globalNotifier0 === 1'b0 ) globalNotifier0 = 1'bx;
  end
  always @ NOT_WEN14 begin
    WEN_int[14] = 1'bx;
    if ( globalNotifier0 === 1'b0 ) globalNotifier0 = 1'bx;
  end
  always @ NOT_WEN13 begin
    WEN_int[13] = 1'bx;
    if ( globalNotifier0 === 1'b0 ) globalNotifier0 = 1'bx;
  end
  always @ NOT_WEN12 begin
    WEN_int[12] = 1'bx;
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
  RET1N && !TEN && ((DFTRAMBYP && !SE) || (!DFTRAMBYP && !TCEN && !TWEN[1] && !TGWEN));
  assign RET1Neq1aTENeq0aDFTRAMBYPeq1aSEeq0oDFTRAMBYPeq0aTCENeq0aTWEN0eq0aTGWENeq0 = 
  RET1N && !TEN && ((DFTRAMBYP && !SE) || (!DFTRAMBYP && !TCEN && !TWEN[0] && !TGWEN));


  assign RET1Neq1aTENeq1aCENeq0 = RET1N && TEN && !CEN;
  assign RET1Neq1aTENeq0aTCENeq0 = RET1N && !TEN && !TCEN;

  assign RET1Neq1aTENeq1 = RET1N && TEN;
  assign RET1Neq1aTENeq0 = RET1N && !TEN;
  assign RET1Neq1aSEeq1 = RET1N && SE;
  assign RET1Neq1 = RET1N;

  specify
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
